AtlasAutoware/car1v2/README.md

# Atlas car 1 v2

Car 1 v2 is the rebuild of car 1, Atlas Autoware's 1/10-scale self-driving race car: a Traxxas Slash 4x4 with a
Holmes Hobbies Puller Pro 540 motor on a carbon-fibre-printed deck, carrying car 1's RPLidar C1 and OAK-D Pro. There
is one car. This repository was named `carv2` until 11 November 2026, and its older files call the car "car v2" or
"car 2". The SICK TiM561 lidar and the LUCID Triton camera that the first design was drawn around are kept for a
later upgrade. Start at `docs/CAR1V2.md`.

Rev B (October 2026) is the electronics design car 1 v2 starts from. Its electronics are:

- **Power board (ATLAS-PWR-1).** A 4-layer board that students solder at school: the motor-bus switch with
  precharge and a hardware E-stop, the power latch, the feeds for the Jetson, lidar, camera, servo and fan, USB-C
  charging, a USB hub so one laptop cable reaches the Jetson, the ESC and the serial console, and a Raspberry Pi Pico
  that sequences it all and talks to the Jetson.
- **The Jetson Orin Nano Super on its NVIDIA dev-kit carrier,** which the team owns, on a printed tray over the power
  board.
- **The team's Flipsky Mini FSESC 6.7 Pro** as the ESC (VESC firmware, the same UART commands as car 1).
- **A JBD 4S smart BMS** with the built-in 4S3P 18650 pack.

`docs/REV_B.md` has the whole design and why it changed. Rev A (two custom boards: a 6-layer drive board with the ESC
on it and an 8-layer Jetson carrier) was finished in September, quoted by PCBWay at $1,927.81 for one assembled set,
and is kept in the repo as history.

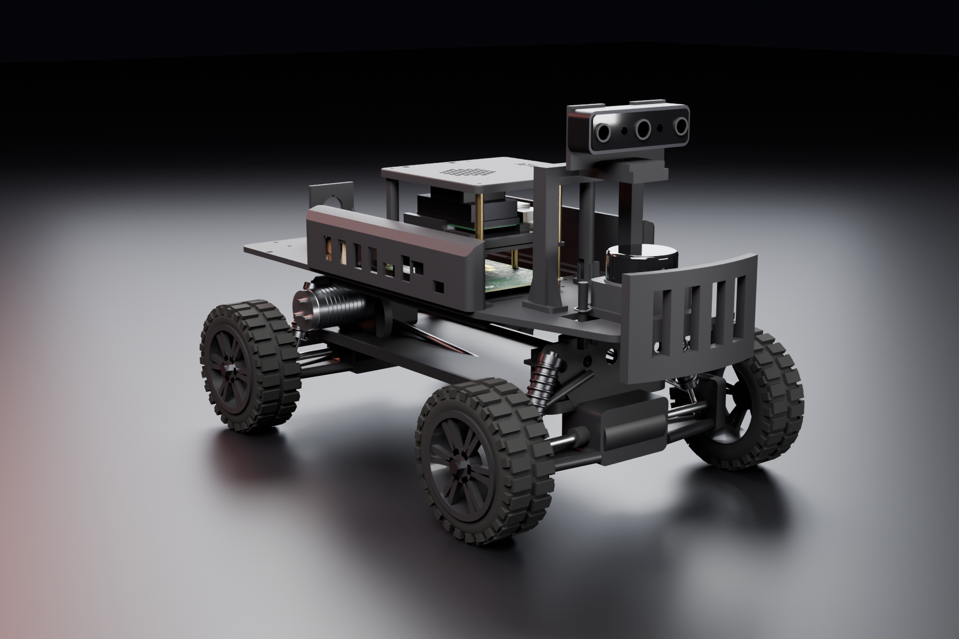
[picture p1: share/car1v2_car_front_left.png]
car 1 v2, stage 1, rendered on a stand-in Slash 4x4


The picture is car 1 v2 as designed on 9 November 2026 (`share/car1v2_scene.py`, `share/render_car.py`). Bought
parts are stand-ins, and the battery, the BMS, the fuse and the cables are not drawn. The rev A renders are
`share/car_*.png`.

## Status

**11 November 2026: the repository is renamed from `carv2` to `car1v2`.** GitHub redirects the old address. Whole-car
renders of car 1 v2 are in `share/car1v2_*.png`, and KiCad 3D renders of the power board are in
`boards/power/out/render/power_iso.png` and `power_top.png`.

**9 November 2026: car 1 v2 is designed and priced on the `rev-b-tht` branch; nothing is ordered, built or merged.**

Car 1 v2 is the rebuild of car 1 on this rev B design. It keeps car 1's RPLidar C1 and OAK-D Pro (the SICK lidar
and the LUCID camera named above are kept for later), runs from a 4S LiPo the team owns behind a JK smart BMS, and
uses the second Jetson dev kit. Start at `docs/CAR1V2.md`.

- Money: stage 1 comes to $967.72 against a $1,500 limit, and $1,272.50 if every estimate turns out badly
  (`bom/car1v2/BUDGET.md`, one cart file per supplier). Five bare boards were quoted on 9 November at $182.34
  (PCBWay) and $117.39 (JLCPCB), both before duty.
- Power board: the copper is unchanged. Three values changed after the review (R419 is 470 ohm, C405 is 150 uF, and
  the capacitor part numbers are ones in stock), and KiCad 10 was re-run on the team laptop on 9 November: ERC 0
  errors, DRC 0 errors, 0 unconnected, 0 schematic parity issues, 47 silkscreen warnings. Parts are $149.40 a board.
- An independent review (`docs/review_car1v2_2026-11-09.md`) checked the schematic, the BOM arithmetic and the budget
  and said "pass with fixes" on each. What was done about every finding is at the end of `docs/CAR1V2.md`.
- The supervisor firmware passes 129 tests on a simulated board. It has not run on a Pico.
- Speed (`docs/PERFORMANCE.md`): on 15/54 gearing the model reaches the 12.5 to 13.5 m/s target, 1.5 to 2.5 m/s
  above the 11 m/s competition benchmark. At equal grip it only matches a standard competition car round a lap, and
  the E-stop does not brake, so it is not safe to run at that speed yet. The mass (5.15 kg), the grip and the motor
  resistance in the model are not measured.
- Aero and cooling (`docs/AERO.md`): four CFD cases at 8 m/s. The wing is left off.
- For the builders: `docs/CAR1V2_QUICK_START.md` (short), `docs/CAR1V2_BUILD.md` (session by session),
  `docs/CAR1V2_CHECKLIST.md` (what to confirm, measure and test by hand), `docs/CAR1V2_WIRING.md`, and a named 3D
  assembly in `mech/out/car1v2/assembly/` (the battery, BMS, fuse and cables are not in it).
- Not verified yet: the bank balance on the day, the LiPo's size and type, the pinion and spur on the chassis, the
  duty rates, and the small-parts prices, which are estimates. `docs/CAR1V2.md` ends with the full list.

**26 October 2026: the rev B power board is routed and its order files are made; nothing is ordered or built yet.**

- An independent pre-order review (`docs/review_revb_2026-10-24.md`) said "fix first, then order; no redesign is
  needed". Its one blocker and seven majors are fixed in the design and the firmware (`boards/power/DESIGN_FIXED.md`,
  `firmware/supervisor/NOTES.md`). It asks for three bench tests before ordering; they are listed in `docs/REV_B.md`.
- The power board is designed and routed (`boards/power/`). `netcheck.py` finds 0 errors and 14 warnings (small
  back-power currents into unpowered pins, all within its limits). It is routed on four layers (2 oz outside, a 1 oz
  ground plane and a 1 oz signal layer inside; two attempts on two layers left 18-21 logic nets open round the Pico),
  and KiCad's DRC finds 0 unconnected items and 0 clearance errors (`boards/power/LAYOUT_NOTES.md`). Parts cost
  $149.37 per board at quantity 1 (`bom/revb/power_board_cost.md`); PCBWay's instant quote for five bare boards is
  $182.34 with shipping. The order files are in `boards/power/out/fab/`, renders in `boards/power/out/render/`.
- Before the boards are ordered: ERC and the KiCad 10 DRC with schematic parity on the team laptop
  (`boards/tools/run_kicad.sh erc-power` and `drc-power`; KiCad 7, used for the layout, cannot read the schematic
  sheets).
- The supervisor firmware (`firmware/supervisor/`) passes its 119 tests on a simulated board. It has not run on a
  Pico.
- The Jetson tools (`software/jetson/`) are rewritten for the dev-kit carrier and the supervisor and pass their tests,
  including the real firmware run against them over a pseudo-terminal. Nothing has run on the car.
- The printed kit (`mech/`) is redone for the dev-kit tray, the ESC cradle and the BMS holder. With a 130 mm power
  board both scripts find zero interference. The tray, the BMS holder, the canopy and the splice plates can also be
  laser-cut from 3 mm sheet, and a 3 mm acrylic shield over the live FET bar is always cut (`mech/README.md`,
  "Laser-cut parts"). The dev-kit carrier's hole positions are placeholders until the owned
  board is measured.
- Still to measure before ordering and printing: `docs/MEASURE_FIRST.md`, items 12 and 17-31. The open questions are
  at the end of `docs/REV_B.md`.

## What is in here

| folder | what |
| --- | --- |
| `docs/` | `REV_B.md` (the rev B design and why), `review_revb_2026-10-24.md` (the independent pre-order review), `BUILD_POWER_BOARD.md` (student assembly guide for the power board), `SOFTWARE.md` (what runs on the car), `FLASHING.md` (programming the Pico, the FSESC and the Jetson), `WIRING.md` (every cable run and its length), `MEASURE_FIRST.md` (numbers to check before printing and ordering), `PACK_BUILD.md` (building the 18650 pack); rev A: `ARCHITECTURE.md`, `TPS25751_CONFIG.md`, `COMPLETE_CAR.md` |
| `boards/power/` | rev B power board: `design.py` is the circuit (every value with its reason), `layout.py` the placement and power copper, `PINMAP.md` the Pico pin map, `README.md` the bench tests, `netcheck.py` the electrical checks; the KiCad schematic is generated from them |
| `firmware/supervisor/` | MicroPython for the Pico on the power board: power sequencing, E-stop latch, BMS reading, the USB link to the Jetson; a simulator and tests that run on a PC |
| `software/jetson/` | the `atlas` command, services and settings for the Jetson (`system/install.sh`), with tests |
| `software/ros2/` | `atlas_power`: battery, E-stop, charging and lidar power in ROS 2 |
| `mech/` | the printed kit: `kit.py` (deck, pods, mounts, pack box, dev-kit tray, ESC cradle, BMS holder) and `extras.py` (canopy, bench stand, plugs and cable paths); `NOTES_REVB.md` has the rev B changes and print list |
| `bom/` | rev A parts list and cost summary; `bom/revb/` the power board's parts and cost per block; `bom/car1v2/` the car 1 v2 budget and one cart per supplier; `cost_summary.md` has both revisions |
| `boards/tools/` | the scripts that build, place, route and check the boards |
| `boards/drive/`, `boards/brain/`, `boards/stack/`, `firmware/vesc/` | rev A (history): the drive board with its VESC target, the Jetson carrier forked from Antmicro's design, and the connector between them |
| `sim/` | rev A circuit and thermal checks; `sim/aero/` the car 1 v2 CFD cases and `sim/perf/` its speed and lap model |
| `share/` | pictures for posting; `car_scene.py` and `render_car.py` render the whole car (rev A; not yet updated) |

## Cost

From `bom/cost_summary.md` and `docs/REV_B.md` (prices from September and October 2026):

| | rev A | rev B |
| --- | ---: | ---: |
| Electronics for one car (rev A: one assembled PCBWay set; rev B: power board parts, BMS, BEC, fuse, leads, lidar adapter, camera cable, and the order of five bare boards) | 1,927.81 | 523.27 |
| Pack materials, lens, charger, fan, hardware, antennas | 402.55 | 376.56 |
| Castle Link (one-time, to set the servo BEC) | | 26.99 |
| **One car, new money** | **2,330.36** | **926.82** |
| **Two cars, new money** (one bare-board order for both) | **about 3,205** | **1,644.31** |

The ESC and the Jetson dev kit are owned and cost nothing new. Assembly is done by students at school. The five bare
boards are PCBWay's instant quote of October 26 ($155.79 + $26.55 DHL), before the Future Innovators discount and
customs.

## Rebuilding

Rev B:

- **Power board design files.** KiCad 7 or later and Python 3, from `boards/tools`:
  ```
  python3 make_footprints.py power
  KICAD_STOCK_SYMBOLS=/usr/share/kicad/symbols python3 build_sch.py power
  KICAD_FP_DIR=/usr/share/kicad/footprints python3 check_fp.py power
  KICAD_FP_DIR=/usr/share/kicad/footprints python3 fp_lib_from_mod.py power    # first run only
  python3 placer.py power --plot ../power/out/placement.png
  python3 ../power/netcheck.py
  python3 ../../bom/revb/make_power_bom.py
  ```
    The board is routed: do not run `placer.py` or `build_pcb.py` again unless the layout is to be redone, because they
  rebuild the board from the placement and drop the routing (`boards/power/LAYOUT_NOTES.md`, "Regenerating"). The
  order files come from `python3 fab_outputs.py power` (KiCad 7 or later). On the laptop with KiCad 10, from the repo
  root: `boards/tools/run_kicad.sh erc-power` and `boards/tools/run_kicad.sh drc-power` before ordering; not
  `pcb-power` or `fab-power`.
- **Printed kit.** `pip install cadquery ezdxf shapely matplotlib`, then from `mech/`:
  `python3 kit.py`, `python3 extras.py` and `python3 ../boards/board_outlines.py` (the default board length is the
  layout's 130 mm; `SHEET_PARTS=all` checks the laser-cut parts in place of the printed ones).
- **Supervisor firmware.** `python3 -m pytest firmware/supervisor/tests`. To put it on a Pico: MicroPython from
  micropython.org, then `mpremote connect /dev/ttyACM0 cp pins.py hal.py jbd.py link.py sequencer.py main.py :` from
  `firmware/supervisor/` (`firmware/supervisor/README.md`).
- **Jetson tools.** `sudo software/jetson/system/install.sh` on the car; tests with
  `python3 -m pytest software/jetson/tests` (needs `pytest`).

Rev A (history):

- Boards: KiCad 10 and Python 3. `boards/tools/run_kicad.sh` runs every step (schematic, board, routing export and
  import, DRC, renders, fabrication files). Careful with `pcb-drive`: it builds the board again from the placement,
  without the routing.
- VESC target: `firmware/vesc/build.sh` (clones VESC 6.06, adds the two target files, builds; needs
  `arm-none-eabi-gcc`). A build of the committed sources is in `firmware/vesc/prebuilt/`.
- Simulations: ngspice and Python with numpy, scipy and matplotlib; `sim/run_all.sh`.
- Whole-car renders: `python3 share/car_scene.py`, then `python3 share/render_car.py -- car_front_left car_exploded`
  with Blender 4.2's `bpy` module. These use the rev A model and no longer run against the rev B kit.

## Licenses

The brain board is derived from Antmicro's Jetson Orin Baseboard (Apache-2.0); its schematic and
board keep Antmicro's notices, and `boards/brain/vendor/antmicro/fetch.sh` downloads the original. The VESC
hardware target is derived from the VESC firmware (GPL-3.0), so those two files are GPL-3.0.
