AtlasAutoware/car1v2/docs/review_car1v2_2026-11-09.md

# Car 1 v2: independent review, 2026-11-09

Scope: the power board schematic as car 1 v2 will use it, the BOM math in `bom/car1v2/`, and the budget.
Read-only. This file is the only thing I wrote. Nothing was ordered, committed or pushed.

A commit landed while I was reading (ffbe478, 21:46 UTC). It changed `docs/CAR1V2.md` and
`docs/CAR1V2_CHECKLIST.md` and added `docs/CAR1V2_BUILD.md`. I read those again. Line numbers below are
for ffbe478.

## 1. Verdict

- **Schematic: pass with fixes.** The E-stop path is hardware, as described. One part value on the dev-kit
  feed (R419) is likely to keep the Jetson unpowered. One wire (Pico GP10 on the E-stop node) lets firmware
  defeat the loop. Neither needs new copper for stage 1.
- **BOM math: pass with fixes.** Every total reproduces to the cent. Two substitute capacitor lines in the
  DigiKey cart are the wrong can and must not be bought. The DigiKey tariff is about $2 low.
- **Budget: pass with fixes.** The arithmetic is right. Stage 1 stays under $1,500 in a pessimistic case
  ($1,225). Stage 1 plus phase 2 does not. Several things the build needs are in no cart.

"Blocker" below means: fix before that order or that build step. It does not mean redesign.

## 2. Findings

| id | severity | area | what is wrong | evidence | suggested fix |
| --- | --- | --- | --- | --- | --- |
| S1 | blocker | schematic, dev-kit feed | The over-voltage cut is likely to hold the Jetson's feed off at every pack voltage. A TL431 below its threshold still draws cathode current once REF is above roughly 1.3 V. That current flows in R419 (10 kOhm, base to emitter of Q404). About 60 uA turns Q404 on, and Q404 pulls the gate of Q402 to its source. Predicted from datasheets, not measured | nets OV_K, OV_B, OV_G: U402, R419, R420, Q404, Q402 (`design.py`:310-318). `netcheck.py`:466-468 and 508-509 treat an off TL431 as open. TI datasheet: Ioff is given only at Vref = 0; Imin 0.4 mA typical. Wikipedia "TL431": 100 to 200 uA below threshold | Fit 470 Ohm at R419 (same 1206 pads; the cart has ten 470 Ohm and uses five). Keep the 16.8 V step in `CAR1V2_BUILD.md` test 2. Try U402, Q404 and the resistors on a breadboard first |
| S2 | should fix | schematic, E-stop | Pico GP10 is wired straight to the ESTOP_OK node. A pin driven high would hold the node at 3.3 V against R1003 with the loop open. The shipped firmware only reads the pin, so "no firmware in the path" holds by firmware convention, not by hardware | net ESTOP_OK: MOD701 pin 14, U302 pins 2 and 5, R1002, R1003, C1001 (`design.py`:460, 583-585; `atlas_power_g_super.kicad_sch`:874). `hal.py`:52-53, `pins.py`:65. `CAR1V2.md`:76-77 | Rev C: 47 kOhm between the node and GP10. On these boards: cut the track at pin 14 and bridge it with 47 kOhm, or accept it and add a test that ESTOP_OK is never an output. Reword `CAR1V2.md`:76-77 |
| S3 | should fix | settings | The Jetson's battery daemon powers the Jetson off at 3.50 V a cell held for 30 s. That is the same 14.0 V and 30 s as the supervisor's warning. With no BMS current the daemon uses the raw pack voltage. So the car shuts down at the "warn" level and the 13.2 V step is only a backstop. The table in `CAR1V2.md` says otherwise | `setup_car1v2.sh`:49-50; `battery.py`:102-103, 219-226; `car_profile.py`:20-21; `CAR1V2.md`:69-70 against 128; `CAR1V2_BUILD.md`:26, 213 | Decide which is wanted. Set `ATLAS_SHUTDOWN_CELL_V` to about 3.35, or rewrite the table as "14.0 V for 30 s: the Jetson shuts down" |
| S4 | should fix | checklist | Step E3 says pull the Pico with the car on. That also cuts the Jetson's DC feed with no shutdown. Q403's base drive comes from the Pico's 3.3 V through R415 | nets +3V3, DEVKIT_PWR, DEV_B: R415, R413, Q403, Q402. `CAR1V2_CHECKLIST.md`:80; `CAR1V2_BUILD.md`:178-179, 212 | Do that test with the Jetson halted or its DC lead unplugged. Say so in E3 |
| S5 | should fix | settings | No regen current limit for the VESC and no charge over-current for the JK BMS are listed. Braking current is charge current to the BMS. If it exceeds the BMS limit the BMS opens during braking and the bus jumps. Rev B listed -12 A and about 20 A | `CAR1V2.md`:116-128; `docs/SOFTWARE.md`:123; `docs/FLASHING.md`:21-22 | Add "battery current max regen -12 A" and "JK charge over-current 20 A or more" to the table and the sign-off |
| S6 | should fix | settings | The supervisor's cut (3.30 V a cell) and the BMS cut (3.20 V) are 0.4 V apart at the pack. The Pico's reading can be off by about that much (1 % resistors, the 3.3 V reference, ADC offset). If it reads high, the BMS cuts first and the Jetson loses power without a shutdown | R703, R704; `pins.py`:85-87; `car_profile.py`:21; `CAR1V2.md`:70-71 | Compare `bat` in the status with a meter at bring-up and store a scale factor. Or set the BMS to 3.00 V, as rev B did |
| S7 | note | schematic, E-stop | Car 1 v2 loses rev B's last fallback: the Pico cannot tell the BMS to open. A main FET that fails shorted leaves only the firmware VESC kill line and the XT90-S. Also, a short between the two loop wires, or loop pin 2 to any voltage above 2 V, reads as "run" | `REV_B.md`:472-473; `sequencer.py`:903-906; J1001 | Say it in `CAR1V2.md`. Test the VESC kill line by itself in E3 |
| S8 | note | docs | "Each branch on the board has its own fuse or polyfuse" is not true. The UBEC feed (J401 on VM), the latch feed (BAT to MOD401 on 18 AWG) and SERVO_V have none. The 5 V branch has only R408 | `CAR1V2.md`:64; nets VM, BAT, SERVO_V, V5_IN | Correct the sentence. Consider an inline blade fuse in the latch lead and in the UBEC lead |
| S9 | note | stage 1 population | With MOD502 off, CHG_GND floats, and Q502 and Q503 float with it. Nothing misreads: CHG_PRESENT_N rests high through R507. F501 with its fuse keeps CHG_RB at pack voltage. The camera pads are live through F403 | nets CHG_GND, CHG_RB, CAM_VIN; `power_board_stage1.csv` rows "F401 F501" and "F402 F403" | Leave the 5 A fuse out of F501 in stage 1. Keep the Kapton over the empty pads |
| S10 | note | DRC text | Three of the 14 silk_over_copper warnings are hub labels over through-hole pads of U601, not over power copper. "None is on a pad" is wrong. No electrical effect | `drc.rpt`:177, 181, 185; `LAYOUT_NOTES.md`:370; `CAR1V2.md`:95-96 | Correct both sentences |
| S11 | note | LiPo | The limits assume 4.20 V cells. A LiHV pack (17.4 V) is over D101's 17.1 V standoff and inside the cut-off's release band. Nobody has recorded the pack type | D101; U402 divider; checklist A1 | Add "LiPo or LiHV" to A1 |
| B1 | blocker | BOM, DigiKey cart | Two substitute capacitors are not "long-lead versions". DigiKey lists EEU-FR1V681L as 10 mm wide and 27 mm seated (a 25 mm can), and EEU-FR1C102L as 8 mm wide with 3.5 mm lead spacing. C101 to C103 sit under the dev-kit tray, limit 23 mm. C404's footprint has 5.0 mm spacing | `make_car1v2.py`:98, 104; `power_board_bom.csv` rows C101 and C404; `mech/kit.py`:54; `CAR1V2.md`:108-110; `CAR1V2_CHECKLIST.md`:66-67; `CAR1V2_BUILD.md`:53-54 | Take both L lines out. Buy a 10 by 20 mm, 5.0 mm pitch 680 uF 35 V part and a 10 by 16 mm, 5.0 mm pitch 1000 uF 16 V part. Read the size on the product page before adding |
| B2 | should fix | BOM, DigiKey cart | The by-hand line for C405 names Nichicon UPW1V221MPD. DigiKey lists it as a 10 mm can with 5.0 mm spacing. The footprint is 8 mm and 3.5 mm. The line also suggests an "L" packaging. No real part was chosen for C405 or for the 10 uF parts | `make_car1v2.py`:118-121; `power_board_bom.csv` row C405 | Pick part numbers and check each against its footprint |
| B3 | should fix | BOM math | The DigiKey tariff is scaled by merchandise ($26.76). The kept lines alone add to $26.86 in the cart's own per-line column. Three kept lines had no figure and the six by-hand lines carry none. About $2 low | `make_car1v2.py`:235; `cart_digikey.csv` tariff column | Sum the per-line figures and estimate the rest |
| B4 | should fix | BOM labels | Two by-hand lines are filed as read today and were not: the 220 uF line as "cart" (it is another part's price) and the tactile switch as "page" (Mouser through findchips, zero stock). `BUDGET.md` opens with "prices read 2026-11-09", but $610.61 of $854.86 is quote or estimate. The basis table says "merchandise only" and includes $168.16 of duty and shipping | `make_car1v2.py`:120-121, 125-126, 312, 346; `BUDGET.md`:3, 37-44 | Relabel both lines "est". Reword the two sentences |
| B5 | should fix | BOM coverage | Needed and in no cart or shelf line: soldering tips, storage for the second Jetson if it has none, a LiPo bag, the 3-pin servo-signal lead from the FSESC to J904, a motor sensor adapter if the plugs differ, thin hookup wire for the latch and the E-stop loop, M3 nuts, M2.5 and M4 screws. The Wi-Fi adapter and joystick receiver are needed in session 7, before the swap | `CAR1V2_WIRING.md`; `cart_other.csv`; `shelf.csv`; checklist A2, A8; `CAR1V2_BUILD.md`:181-190 | Add lines with estimates. About $110 with tax in my pessimistic case |
| B6 | note | BOM coverage | The cart builds one board, not five. Eight parts are bought once: U401, MOD401, MOD601, J409, J601, U601, J801, J1003 | `cart_digikey.csv` | Fine if intended. Say so |
| B7 | note | BOM math | The DigiKey row in `BUDGET.md` adds to 203.94 from its own cells; the total shows 203.95. Rounding only. Two doc figures do not match the BOM: "about $4" for the parts left for later is $7.86, and "About $11" for the hub block is $15.84 at cart prices | `BUDGET.md`:28; `CAR1V2.md`:85, 101; `power_board_stage1.csv` | Cosmetic |
| M1 | should fix | budget, docs | `CAR1V2.md` and `BUDGET.md` disagree twice. "Five in-stock substitutes went into the cart": three are in the cart, two are unspecified by-hand lines. "Six DigiKey lines not read today": `BUDGET.md` files two of them as read today | `CAR1V2.md`:108-110, 162-164; `BUDGET.md`:41-42, 46 | Align the text |
| M2 | note | budget | Stage 1 plus phase 2 has $80.54 of room. A duty of 61 % alone removes it. So does 55 % duty with small parts 15 % over. Stage 1 alone holds | my recomputation; `BUDGET.md`:54 | Treat phase 2 as not yet affordable inside the cap |
| M3 | note | budget | The pending bank items (Micro Center $199.11, FS.COM $83.08, Adafruit $31.49) are not explained. If any is car 1 v2 spending it counts toward the $1,500 | `make_car1v2.py`:21-22 | State what they were for |
| M4 | note | docs | `CAR1V2.md` says "the reviewer checked that path" before any review existed | `CAR1V2.md`:77 | Replace with this review's result (S2, S7) |
| F1 | note | firmware tests | `test_healthy_lipo_is_left_alone` asserts on an event name that does not exist ("bat_low"; the event is "low_battery"), so it cannot fail. No test sits at the 14.0 V and 13.2 V edges. I ran the edges by hand and they behave as documented | `test_car_profile.py`:53; `sequencer.py`:453, 463 | Fix the name. Add cases at 13.95, 14.05, 13.15 and 13.25 V |

## 3. Detailed answers

### How I checked the schematic

I read `design.py` and `chips_power.py`, then checked them against three other things. First, the netlist in
`atlas_power_parts.json` (215 parts, 133 nets). Second, the net labels in the `.kicad_sch` sheets for the
nets that matter here. Third, the pad nets in `atlas_power.kicad_pcb`: all 574 pads match the netlist. The
sheets are KiCad 9 format files (`version 20250114`), not KiCad 7. The board file is KiCad 7 format.

### 1a. E-stop

The path, in order:

1. `+3V3` (the Pico's 3.3 V output) through R1001 (1 kOhm) to J1001 pin 1, net ESTOP_SRC.
2. The normally closed button and its two wires.
3. J1001 pin 2, net ESTOP_IN, with BAT85 clamps D1001 to GND and D1002 to +3V3.
4. R1002 (100 Ohm) to the node ESTOP_OK, which has R1003 (10 kOhm) and C1001 (10 nF) to GND.
5. ESTOP_OK to U302 (74HCT08) pins 2 and 5. Pin 1 is MAIN_EN, pin 4 is PRECHARGE_EN.
6. U302 pin 3, AND_MAIN, through R305 (1 kOhm) to MIC_IN, with R306 (100 kOhm) to GND.
7. U301 (MIC5014) pin 2 in, pin 5 out to SW_GATE, then R301 to R303 (10 Ohm) to the three gates. R304
   (2.2 MOhm) ties gate to source.
8. For precharge: U302 pin 6, AND_PRE, through R311 to Q305, which pulls the gate of Q304.

There is no firmware-controlled part in series. The cases asked about:

- **Loop wire broken or button unplugged.** ESTOP_IN floats. R1003 holds ESTOP_OK at 0 V. Both AND outputs
  go low. R306 holds MIC_IN low. The switch opens and precharge is off. The node falls below the gate's 0.8 V
  low level in about 0.13 ms.
- **Pico unpowered or pulled out.** `+3V3` has no other source, so the loop has no supply and ESTOP_OK is 0 V.
  R307 and R308 (100 kOhm) hold MAIN_EN and PRECHARGE_EN low. The switch opens. The Jetson's feed also drops
  (finding S4).
- **Pico in reset, pins floating.** R307 and R308 hold both enables low. The switch opens. ESTOP_OK does not
  depend on the Pico's pin state in reset.
- **74HCT08 out of its socket or without 5 V.** R306 holds MIC_IN low. Switch open.
- **MIC5014 out of its socket.** R304 holds the gates at the source. Switch open.

What is not as strong as the docs say:

- GP10 sits directly on ESTOP_OK (finding S2). The shipped firmware makes it an input with no pull
  (`pins.py`:65, `hal.py`:52-53) and hangs an interrupt on it (`hal.py`:112). No code path makes it an output.
  But a wrong pin table, a bug, or someone at the REPL can drive it high, and 10 kOhm cannot hold it down. An
  internal pull-up alone cannot defeat the loop: I estimate under 0.6 V at the node. I took the RP2040's
  pull-up value (50 to 80 kOhm) from memory. Not verified.
- The loop is one channel. A short between its two wires reads as "closed". So does pin 2 touching anything
  above 2 V.
- A main FET that fails shorted defeats the hardware layer. Rev B answered that with "the Pico can tell the
  BMS to open" (`REV_B.md`:472-473). On car 1 v2 the BMS is not on the UART, so that answer is gone (S7).
- The E-stop cuts the motor bus only. The UBEC is on that bus, so steering drops too and the car coasts.
  The Jetson stays on. This is by design, and worth saying to the students.

### 1b. Stage 1 population

With MOD402, MOD501 and MOD502 not fitted, and R801, R802 and R805 never fitted:

| input or node | state in stage 1 | does it matter | firmware |
| --- | --- | --- | --- |
| CHG_PRESENT_N (GP15) | high through R507 (10 kOhm). Q503's emitter is on CHG_GND, which floats, so it cannot pull the line low. Leakage through Q502 and Q503 is nanoamps against 10 kOhm | no | reads "no charger". The low-pack checks are never paused (`sequencer.py`:276, 445). Correct |
| CHG_GND island (Q502, Q503 emitters, R504, R506, D501, C501, TP502) | floats. Its only tie to GND was inside MOD502 | no. Q501's gate is held off by R501 to CHG_RB, not by the island | none needed |
| CHG_RB, Q501 source | at pack voltage through F501 if its fuse is fitted | harmless, but a live unused branch (S9) | none |
| CHG_OUT, CHG_IN pads | float | no | none |
| CAM_VIN pads | at pack voltage through F403 whenever the latch is on. D406 across them | bare live pads. Kapton, as the build guide says | none. There is no camera enable or power-good net on this board |
| BMS_RX (GP1) | idle high through R202 with J201 empty | no | BMS reported offline; `bms_fets` returns an error; pack voltage comes from the ADC. Tested (`test_car_profile.py`:21-27) |
| I2C0_SDA, I2C0_SCL (GP4, GP5) | float. R801 and R802 are not fitted | no. The pins are never read | set as inputs with no pull (`pins.py`:75). A pull-down would be tidier |
| J12_CTS | floats at the Jetson (R805 not fitted) | same as rev B | none |
| LIDAR_V at J409 | off at boot (`LIDAR_AT_BOOT = False`). Goes live if the Jetson raises LIDAR_REQ | nothing is plugged in | handled |
| VM_SENSE, BAT_SENSE, FET_NTC | unchanged. None depends on a missing module | no | unchanged |

There is no "charge enable" output in this design. The charge path is gated in hardware by D502 and Q502.

The pack still powers the board. The pack comes in on J101 and J102 straight to BAT. The charge path is a
separate branch into BAT and is not in the way.

Two inputs change behaviour against rev B: the BMS never answers, and the lidar feed stays off. The firmware
handles both.

### 1c. LiPo instead of the 18650 pack

A 4S LiPo and the 4S 18650 pack have the same full voltage, 16.8 V. So no rating gets tighter. What changes
is that the pack type is unknown (S11).

| part | limit | at 12.0 to 16.8 V | at a spike | source |
| --- | --- | --- | --- | --- |
| D101 1.5KE20A (BAT) | standoff 17.1 V, breakdown 19.0 to 21.0 V, clamp 27.7 V | 0.3 V under the standoff at a full pack | clamps | values from `design.py`:142. Not read on a datasheet today |
| D301 1.5KE22A (VM) | standoff 18.8 V | fine | clamps at about 30.6 V | standoff from `design.py`:218; the clamp figure is from memory. Not read today |
| C101 to C103 | 35 V | fine | fine | DigiKey page |
| C104, C301, C302 | 50 V | fine | fine | part numbers |
| U301 MIC5014 | 2.75 to 30 V operating, 60 V absolute, gate clamp 13 to 17 V, shuts off at 35 V minimum | fine | under 30 V at the clamp | MIC5014/5015 datasheet copy at docs.rs-online.com, read today |
| Q301 to Q303 IRFB7430 | 40 V | fine | fine | `chips_power.py`. Not read today |
| Q304, Q405 IRF9Z34N | 55 V, gate 20 V | gate at -8.4 V at 16.8 V | -13.9 V at 27.7 V | arithmetic from R309, R310 |
| U401 R-78E5.0-1.0 | 8 to 28 V in, behind R408 and D401 (P6KE20A) | fine down to the 13.2 V cut | clamped near 20 V | `design.py`:237. Not read today |
| MOD401 Pololu 2813 | 4.5 to 40 V per the repo | fine if that is right | fine if that is right | not verified: the Pololu page was blocked |
| Q402 IRF4905 | 55 V, gate 20 V | gate at -7.1 V at 12 V, -10 V at 16.8 V | -18.2 V at 30.6 V | arithmetic from R411, R412 |
| U402 over-voltage cut | see below | does not trip | trips | arithmetic |
| C404 on SERVO_V | 16 V | 7.4 V from the UBEC | not on the pack rail | BOM |
| C405 on VDEV | 35 V | fine | fine | BOM |
| VM_SENSE, BAT_SENSE | 100 kOhm over 18 kOhm, factor 0.1525 | 2.56 V at 16.8 V | see below | arithmetic |

**The over-voltage cut.** With R416 100 kOhm, R417 15.0 kOhm, R418 1.2 MOhm and the gate at 0.405 of the feed:

- Trip: 18.7 V with no reference current, 18.9 V with the typical 2 uA. With 1 % resistors, the A-grade
  reference (2.470 to 2.520 V) and 0 to 4 uA, the range is about 18.2 to 19.6 V. Allowing for drift, about 18.0 V
  at the lowest. The docs say 18.7 V.
- Release: 17.85 V nominal, 17.4 V at the low corner, about 17.2 V with drift. The docs say 17.85 V.
- A full pack at 16.8 V is at least 1.2 V under the lowest trip and at least 0.4 V under the lowest release.
  The highest trip, 19.6 V, is under the carrier's 20 V. So the thresholds are right.
- The problem is not the threshold. It is the off-state current (S1). The TI datasheet gives the off-state
  cathode current only for Vref = 0, and lists 2 uA typical into REF and 0.4 mA typical minimum cathode
  current. The REF pin here sits at 1.6 V (12 V pack) to 2.24 V (16.8 V pack). In that state the Wikipedia
  article on the TL431 puts the cathode current at 100 to 200 uA, climbing to 300 to 500 uA close to the
  threshold. A TI application note (SNVAA58) describes the same state as a few microamps, so the sources
  disagree. At 100 uA, R419 would drop 1 V, which is more than Q404 needs to turn on. Q404 then holds Q402
  off, and R418 feeds REF a little more, so it stays that way. `netcheck.py` cannot see this because it
  models the off state as an open circuit. With 470 Ohm at R419, Q404 needs about 1.2 mA to turn on, which
  is above the 0.6 mA maximum the datasheet gives for the A grade, and it still gets 2 mA of base current
  at the trip point. The build guide's test 2 would catch this on the bench. The fix costs nothing.

**The ADC dividers.** At 16.8 V the pins see 2.56 V. They reach 3.3 V at 21.6 V on the bus. At the pack TVS
clamp (27.7 V) the divider would give 4.2 V open-circuit, so the Pico's pad diode conducts: about 30 uA. At
the motor-bus clamp (30.6 V), about 60 uA. So they do not stay under 3.3 V at the clamp. They rely on the
pad diode at a very small current for the length of the spike. I did not read the RP2040's limits. Not
verified.

**Regen.** The repo's answer is the VESC's 18 V input limit, with the TVS parts as backstop. That is unchanged.
The missing piece for this car is the pair of regen settings in S5.

### 1d. Supervisor with no BMS traffic

- `python3 -m pytest firmware/supervisor/tests -q`: 126 passed. The Jetson tools: 77 passed. Both match
  `CAR1V2.md`:142-143.
- Boot and main switch with a silent BMS: yes. `main.App` always builds a `JbdClient`; it times out and
  reports offline; `_bms_watch` does nothing more (`sequencer.py`:468-479). The rig reaches RUN with MAIN_EN
  and VESC_KILL high and the lidar feed off.
- Low pack from its own ADC: yes. `_battery` (`sequencer.py`:431-466) uses the filtered BAT_SENSE reading only.
- Thresholds: `car_profile.py`:20-21 has 14.0 V and 13.2 V. `BAT_LOW_MS` 30 s and `BAT_CUT_MS` 10 s are
  inherited. These match `CAR1V2.md`:69-70 and the VESC cut-off line.
- I ran the rig at the edges, outside the repo. 14.05 V: no event in 60 s. 13.95 V: warning at 30.1 s. 13.25 V:
  warning only. 13.15 V: shutdown requested at 10.1 s. A sag from 15.2 V to 12.9 V needs about 14 s before it
  cuts, because of the 2 s filter. A pack that reads under 10 V at power-on ends in FAULT.
- Sensible for a 4S LiPo? Yes as starting values. 3.50 V a cell at cruise current is roughly the last fifth
  of the pack. 3.30 V held for 10 s leaves room above 3.0 V. Two caveats: S3 (the Jetson acts at 14.0 V on its
  own, so the 13.2 V step is rarely reached) and S6 (measurement error against the BMS's 3.20 V).
- Test quality: F1.
- One thing outside the supervisor: the Jetson's estimator uses 8.4 Ah (`board.py`:51) and counts charge
  from BMS current. With no current, its state of charge stays at the start value. "Battery telemetry, pack
  level" means voltage only.

### 1e. The servo

- The UBEC's input is J401 (BEC+, net VM) and J402 (GND). Its output plugs into J403: pin 1 not connected,
  pin 2 SERVO_V, pin 3 GND. J404 and J405 are solder pads on the same nets.
- The servo plugs into J406: pin 1 SERVO_SIG, pin 2 SERVO_V, pin 3 GND.
- The FSESC's signal comes in on J904 pin 1 through R903 (10 kOhm) to U302 pin 9. The buffer output goes
  through R410 (220 Ohm) to J406 pin 1. J904 pin 2 is not connected, so the FSESC's own 5 V cannot meet the
  UBEC's 7.4 V. J904's ground goes through R906 (3.3 Ohm).
- Parts on SERVO_V: J403, J404, J406, C404 (1000 uF 16 V) and TP403. Nothing rated 5 V is on it. The only
  5 V part near it is the buffer, and it drives the signal pin through 220 Ohm. 7.4 V is safe. 8.4 V would be
  too.
- Copper: the class is 2.5 mm on 2 oz. The built track is 2.0 mm for 61 mm, 1.9 mm for 27 mm and 1.6 mm for
  9 mm (`LAYOUT_NOTES.md`:300). That carries several amps.
- There is no fuse or polyfuse on SERVO_V, and none on the UBEC's input lead (S8). The 2.54 mm header pins
  are rated about 3 A (from memory, not read today) and a stalled 35 kg cm servo can draw more for a moment. If the UBEC has bare output
  wires, solder them to J404 and J405 instead of using J403. I did not find the INJS235's stall current. Not
  verified.
- The substitute bought for C404 has the wrong lead spacing (B1).
- The UBEC loads the motor bus during precharge. Checklist C2 and build test 4 cover that.

### 1f. The ERC and DRC reports

- `erc.rpt`: 0 errors, 0 warnings. As claimed. The ignored checks are library and footprint-link checks, not
  pin or power checks.
- `drc.rpt`: 47 violations, all warnings: 33 silk_overlap and 14 silk_over_copper. 0 unconnected pads.
  0 footprint errors. As claimed.
- On a pad or an electrical feature? The 33 are silkscreen against silkscreen. Of the 14, eleven are against
  the mask openings over the BAT and VM copper. Three are hub labels over through-hole pads of U601 (pads 1,
  13 and 2). So "all on the bare power copper" and "None is on a pad" are not exact (S10). The fab clips ink
  at mask openings, so there is no electrical effect.
- The board file carries `dnp` on R801, R802 and R805 and on nothing else. Commit 0071d04 changed those three
  attribute lines only. The Gerbers in `out/fab` date from 9963a99 (Oct 26) and are unaffected.
- The reports are stamped 15:48 local time. If the laptop is on US Eastern time, that is seconds after the
  commit (20:47 UTC), so they describe the board with the flag. I could not rerun them: KiCad is not
  installed here.

### 1g. Other defects, ranked

1. S1, the TL431 off-state current. Likely to stop the Jetson powering at all.
2. S2, GP10 on the E-stop node.
3. S3, the Jetson shutting down at the warning level.
4. S4, the Pico-pull test cutting the Jetson.
5. S5 and S6, the missing regen settings and the uncalibrated cut level.
6. S7 to S11, notes.

Two more small ones. There is no reverse-polarity protection at the BAT pads, and D101 conducts forward if the
pigtail is soldered backwards, so meter the pigtail before the first plug-in. And the BOM names TL431ACLPRE3,
a formed-lead part, for a straight-lead TO-92 footprint; the by-hand line allows TL431ACLP, which is the
straight one.

### 2a. Recomputed totals

I recomputed from the CSV files with my own script, in exact decimals.

| figure | files say | I get |
| --- | --- | --- |
| DigiKey cart, all 79 lines | 164.72 | 164.72 |
| DigiKey kept lines (73) | (not shown) | 150.69 |
| DigiKey by-hand lines (6) | (not shown) | 9.96 |
| DigiKey merchandise | 160.65 | 160.65 |
| DigiKey tariff, scaled | 26.76 | 26.76 by the script's method; 26.86 from the kept lines' own column, before the unread and by-hand lines (B3) |
| DigiKey tax | 11.54 | 11.54 |
| DigiKey total | 203.95 | 203.95 (the row's cells add to 203.94) |
| PCBWay, one order | 236.87 | 236.87 (duty 54.53 is 35 % of 155.79) |
| Amazon BMS with tax | 70.48 | 70.48 |
| Hobbywing with tax | 32.85 | 32.85 |
| Small parts with tax | 130.37 | 130.37 |
| **Stage 1** | **911.39** | **911.39** |
| Phase 2 with tax | 508.07 | 508.07 |
| Phase 2, borrowed welder | 185.29 | 185.29 |
| Sensor upgrade with tax | 84.64 | 84.64 |
| Stage 1 + phase 2 | 1,419.46 | 1,419.46 |
| Stage 1 + phase 2 (borrowed welder) + upgrade | 1,181.32 | 1,181.32 |
| Stage 1 + phase 2 + upgrade | 1,504.10 | 1,504.10 |
| Basis: cart, page, quote, est | 152.11, 92.14, 371.56, 239.05 | the same |
| Board population: fitted, left off | 105.47, 43.90 | the same; they add to the rev B BOM's 149.37 |

Every line is quantity times unit price to the cent. The only differences of a cent or more are the row
rounding (B7) and the tariff method (B3).

### 2b. Coverage

Every row marked "fit" has a line that buys it, for one board. The three that are not DigiKey part lines:
the heatsink bar (SendCutSend gift code), the Pico's headers (the cart buys the Pico H, which has them), and
the hub module's headers, the M3 nuts and the Kapton (not bought as such; Kapton is in a small-parts line).

The cart builds one complete board (B6). No part is bought that the board does not use, apart from spares and
the dev-kit DC lead, which is a harness part. Six lines sit in the cart that must come out or be decided
before checkout: five to delete ($8.08) and the PD trigger ($5.95).

Substitutes against the footprint in the BOM row:

| refs | BOM footprint | substitute | check |
| --- | --- | --- | --- |
| C101 to C103 | CP_Radial_D12.5mm_P5.00mm | EEU-FR1V681L | 680 uF 35 V. 10 mm can, 5.0 mm spacing: fits the holes. 27 mm seated maximum: 4 mm over the tray limit. **Wrong** |
| C404 | CP_Radial_D10.0mm_P5.00mm | EEU-FR1C102L | 1000 uF 16 V. 8 mm can, 3.5 mm spacing against 5.0 mm holes, 22 mm seated maximum. **Wrong** |
| C104, C603, C604 | C_1206 | KEMET C1206C105K5RACTU | 1 uF, 50 V, X7R, 1206 by its part-number code. Fits. Not read on a page |
| five 10 uF | C_1210 | "any", for example KEMET C1210C106K5RACTU | the example decodes as 10 uF, 50 V, X7R, 1210. No part chosen |
| C405 | CP_Radial_D8.0mm_P3.50mm | "any"; names UPW1V221MPD | the named part is 10 mm and 5.0 mm. **Wrong example.** No part chosen |

Pages read: DigiKey product pages for EEU-FR1V681L, EEU-FR1C102L, EEU-FR1V681, EEU-FR1C102, EEU-FR1V221 and
UPW1V221MPD (regional DigiKey sites; I used the size attributes only, not price or stock).

A side finding: DigiKey lists the original EEU-FR1V681 as a 10 mm can, 22 mm seated. The rev B BOM calls it
12.5 by 20 mm. The footprint is drawn larger than the part. Harmless.

### 2c. Tax, shipping, and every item in the wiring diagram

Tax is on DigiKey (merchandise, tariff and shipping), Amazon, Hobbywing (with shipping) and small parts. It
is not on PCBWay, which carries duty instead. That is right, and slightly generous where shipping is taxed.
Nothing is counted twice: the PD trigger is in the DigiKey file as "phase2" and is costed only in phase 2.
The second board order is in stage 1 as a reserve, $236.87.

Not counted: the tariff on the by-hand lines, a carrier's duty-handling fee if PCBWay does not collect duty at
checkout, shipping on small parts from sellers that charge it, and a split shipment for the three backordered
DigiKey lines.

| item in the wiring diagram | where it comes from |
| --- | --- |
| 4S LiPo | `shelf.csv` (car 1's packs; size, rating and type unrecorded) |
| MIDI fuse 100 A and holder | small parts, estimate $12.00 |
| JK BMS | Amazon, $66.49 |
| XT90-S | small parts, estimate $6.00 |
| 10 AWG leads, ring terminals, heat-shrink | small parts, estimates $10.00 and $7.00 |
| XT90 to mate with the pack, XT90 male for the board pigtail | `shelf.csv` (three XT90s, two bare-wire cables; gender and gauge unconfirmed, checklist A6) |
| balance-lead extension | small parts, estimate $6.00 |
| bare board | PCBWay |
| board parts, Pico, hub, latch | DigiKey cart |
| latch wiring: 18 AWG | small parts (16 and 18 AWG wire, $8.00) |
| latch ON and OFF wires, thin | **not listed** |
| E-stop button | small parts, estimate $9.99 |
| E-stop lead to J1001 | the pre-crimped JST lead line, estimate $9.00. Length to the tail not checked |
| FSESC | `shelf.csv` (the spare) |
| ESC power leads, motor phase leads and bullets | assumed to be on the FSESC and motor. Not verified |
| motor sensor lead | "in the box", checklist A4. Adapter to the FSESC's socket **not listed** |
| UBEC | Hobbywing Direct, $24.99 plus $6.00 estimated shipping. Output plug type unknown (checklist B8) |
| servo | `shelf.csv` |
| FSESC servo-signal lead to J904 | **not named** in any line |
| FSESC COMM lead to J903, J14 harness | the pre-crimped lead and Dupont line |
| dev-kit DC lead | DigiKey, $4.51 |
| second Jetson | `shelf.csv`. Storage unconfirmed |
| 40-wire ribbon | small parts, estimate $4.00 |
| Pico USB lead, three hub leads | the USB leads line, estimate $22.00 |
| RPLidar C1, OAK-D Pro and their leads | car 1, moved on swap day |
| Wi-Fi adapter, joystick receiver | car 1, moved on swap day. **Not in `shelf.csv`**, and needed in session 7 before the swap |
| laptop USB-C cable | not listed; assumed owned |
| fan | `shelf.csv` (model unconfirmed) |
| heatsink bar, acrylic shield | SendCutSend gift code |
| standoffs, inserts, Kapton, ties, plywood | small parts, estimates |

### 2d. Price labels

- Labelled as read today and not: the 220 uF by-hand line ("cart", but it is the price of a different,
  backordered part) and the tactile switch ("page", but read at Mouser through an aggregator, for a part to
  be bought at DigiKey).
- Labelled as an estimate though a price was read: the TL431 ($0.50 against $0.14 read on Oct 24). This errs
  high.
- `BUDGET.md` line 3 says the prices were read on 2026-11-09. By its own table, $244.25 was read that day and
  $610.61 was not.
- The Hobbywing price I could check: the Hobbywing Direct page shows $24.99. The page does not say how the
  output voltage is selected, so "its voltage is a jumper" is not verified.

### 3a. Bank arithmetic

1,895.60 + 250.00 - 199.11 - 83.08 - 31.49 = 1,831.92. Correct.
After stage 1: 1,831.92 - 911.39 = 920.53. Correct. Under the cap: 1,500.00 - 911.39 = 588.61. Correct.
After stage 1 and phase 2: 1,831.92 - 1,419.46 = 412.46. Under the cap: 80.54. Correct.
With the sensor upgrade as well: 327.82 left in the account, 4.10 over the cap. Correct.

### 3b. `CAR1V2.md` against `BUDGET.md`

These agree: 1,831.92; 1,500; 911.39; 66.49; 24.99; 73.94 for the Castle parts; 508.07; 185.29; 1,419.46;
84.64; "$323" for the welder with tax (322.78); 35 % duty; 6 % tax; five boards.

These do not: the two items in M1; the low-voltage table against the Jetson setting (S3); "about $4" and
"About $11" (B7).

### 3c. What moves the total

| assumption | change | stage 1 moves by |
| --- | --- | --- |
| the reserve second board order is not needed | drop it | -236.87 |
| PCB quote | +10 % | +42.06 (two orders, with duty) |
| duty rate | +10 points | +31.16 (two orders) |
| small-parts estimates | +10 % | +13.04 |
| sales tax | +1 point | +4.13 |
| DigiKey tariff counted by line | about +2 | +1.84 |

The largest single item is whether the second board order happens. After that, the PCB quote and the duty.

A pessimistic but plausible stage 1: PCB quote 15 % higher, duty 55 %, DHL 10 % higher, small parts 30 % over
plus $15 shipping, DigiKey by FedEx with the tariff by line, Hobbywing shipping $10, and $103 of the missing
items in B5 (tips $28, storage $45, LiPo bag $12, leads $10, wire $8). That comes to **$1,225.45**, with the
reserve order included. It clears $1,500 by $274.55. With one board order it is $918.54. Adding phase 2 to the
pessimistic case gives $1,733.52, which does not clear.

### 3d. Missing from the money

Listed in B5. The ones that could stop the car driving: storage for the second Jetson (if checklist A2 finds
none), soldering tips (if A8 finds none), the servo-signal lead, and a sensor adapter if the motor's plug and
the FSESC's socket differ. The bench tests in the checklist also assume a current-limited supply, a scope, a
4.7 Ohm 50 W resistor and a load for 50 A pulses (A11). None is priced.

## 4. What I could not verify

- **S1 is a prediction.** No hardware exists. Two sources support it and one TI note disagrees. A breadboard
  settles it in minutes.
- KiCad's ERC and DRC. I read the two report files. I could not rerun them.
- Whether the Gerbers in `out/fab` match the board file. I checked only that the one later commit touched
  attribute lines.
- Datasheet values taken from the repo and not read today: the TVS parts, the IRF FETs, the R-78E, the
  74HCT08, the PC817, the Pico's pin limits and pull values.
- Blocked or failed pages: pololu.com/product/2813 (the latch's limits and its ON pin), chenshuo.com/notes/tl431
  (a TL431 circuit analysis), and one allaboutcircuits.com thread. The TI datasheet was read only through its
  first 100,000 characters, which covered the tables and the comparator section; the cathode-current figure
  could not be read as numbers.
- The JK BMS: its supply range, its delays, whether its limits can be set as the docs ask, and how it wakes.
  One seller's page lists 4S to 8S and 100 A; nothing else.
- The INJS235's stall current, the UBEC's output plug and voltage selector, the FSESC's connectors and pin
  order, and the motor's sensor plug.
- Every DigiKey price and stock figure. I checked the arithmetic and six part sizes, not the cart.
- The bank figures, and what the three pending debits were for.
- The mechanical fit of anything. I used the 23 mm limit in `mech/kit.py` as given.
- `sim/` and the aero work. Not opened, as asked.

What I ran: the two pytest suites (cache writing off for the second; the first refreshed git-ignored
`__pycache__` files), and four short scripts of my own kept outside the repository.
