AtlasAutoware/car1v2/sim/perf/out/summary.md

| pinion / spur | overall ratio | top speed: worst case | nominal | best case | launch force at 60 A | grip at mu 0.8 | motor rpm at 13.5 m/s |
| --- | ---: | ---: | ---: | ---: | ---: | ---: | ---: |
| 13 / 54 | 11.84 | 13.6 m/s | 14.5 m/s | 15.9 m/s | 47.9 N | 40.4 N | 27,875 |
| 14 / 54 | 10.99 | 14.5 m/s | 15.6 m/s | 17.1 m/s | 44.4 N | 40.4 N | 25,884 |
| 15 / 54 | 10.26 | 15.3 m/s | 16.6 m/s | 18.2 m/s | 41.5 N | 40.4 N | 24,158 |
| 16 / 54 | 9.62 | 16.2 m/s | 17.5 m/s | 19.3 m/s | 38.9 N | 40.4 N | 22,649 |

| straight between two 5 m/s corners | 8 m | 10 m | 12 m | 14 m | 16 m | 18 m | 20 m | 22 m | 25 m | 30 m |
| --- | ---: | ---: | ---: | ---: | ---: | ---: | ---: | ---: | ---: | ---: |
| reference car | 9.3 | 10.1 | 10.9 | 11.5 | 12.1 | 12.6 | 13.1 | 13.6 | 14.2 | 15.2 |
| car 1 v2, regen 12 A | 9.1 | 9.8 | 10.3 | 10.9 | 11.4 | 11.9 | 12.3 | 12.8 | 13.3 | 14.2 |
| car 1 v2, regen 30 A | 9.3 | 10.2 | 10.9 | 11.6 | 12.2 | 12.8 | 13.4 | 14.0 | 14.7 | 15.4 |
| car 1 v2, regen 30 A, capped at 13.5 | 9.3 | 10.2 | 10.9 | 11.6 | 12.2 | 12.8 | 13.4 | 13.5 | 13.5 | 13.5 |

**team comp_track race line (243 m)**

| car | lap | top speed | average |
| --- | ---: | ---: | ---: |
| reference car | 35.91 s | 15.97 m/s | 6.78 m/s |
| car 1 v2, regen 12 A | 36.21 s | 15.04 m/s | 6.72 m/s |
| car 1 v2, regen 30 A | 35.86 s | 15.93 m/s | 6.79 m/s |
| car 1 v2, regen 30 A, capped at 13.5 | 35.97 s | 13.5 m/s | 6.77 m/s |
| reference car, mu 0.6 | 41.41 s | 14.71 m/s | 5.88 m/s |
| car 1 v2, regen 30 A, mu 0.6 | 41.39 s | 14.81 m/s | 5.88 m/s |
| reference car, mu 1.05 | 31.6 s | 16.55 m/s | 7.7 m/s |
| car 1 v2, regen 30 A, mu 1.05 | 31.69 s | 16.21 m/s | 7.68 m/s |
| car 1 v2, regen 30 A, 4.54 kg | 35.86 s | 16.04 m/s | 6.79 m/s |
| car 1 v2, regen 30 A, 5.76 kg | 35.93 s | 15.78 m/s | 6.78 m/s |

**box, 26 x 9 m centre line (66 m)**

| car | lap | top speed | average |
| --- | ---: | ---: | ---: |
| reference car | 9.67 s | 13.18 m/s | 6.79 m/s |
| car 1 v2, regen 12 A | 9.8 s | 12.35 m/s | 6.7 m/s |
| car 1 v2, regen 30 A | 9.66 s | 13.47 m/s | 6.8 m/s |
| car 1 v2, regen 30 A, capped at 13.5 | 9.66 s | 13.47 m/s | 6.8 m/s |
| reference car, mu 0.6 | 11.16 s | 11.64 m/s | 5.89 m/s |
| car 1 v2, regen 30 A, mu 0.6 | 11.15 s | 11.66 m/s | 5.89 m/s |
| reference car, mu 1.05 | 8.55 s | 14.04 m/s | 7.68 m/s |
| car 1 v2, regen 30 A, mu 1.05 | 8.67 s | 14.26 m/s | 7.58 m/s |
| car 1 v2, regen 30 A, 4.54 kg | 9.66 s | 13.46 m/s | 6.8 m/s |
| car 1 v2, regen 30 A, 5.76 kg | 9.75 s | 13.18 m/s | 6.74 m/s |
