AtlasAutoware/car1v2/boards/power/out/render/power_iso.png

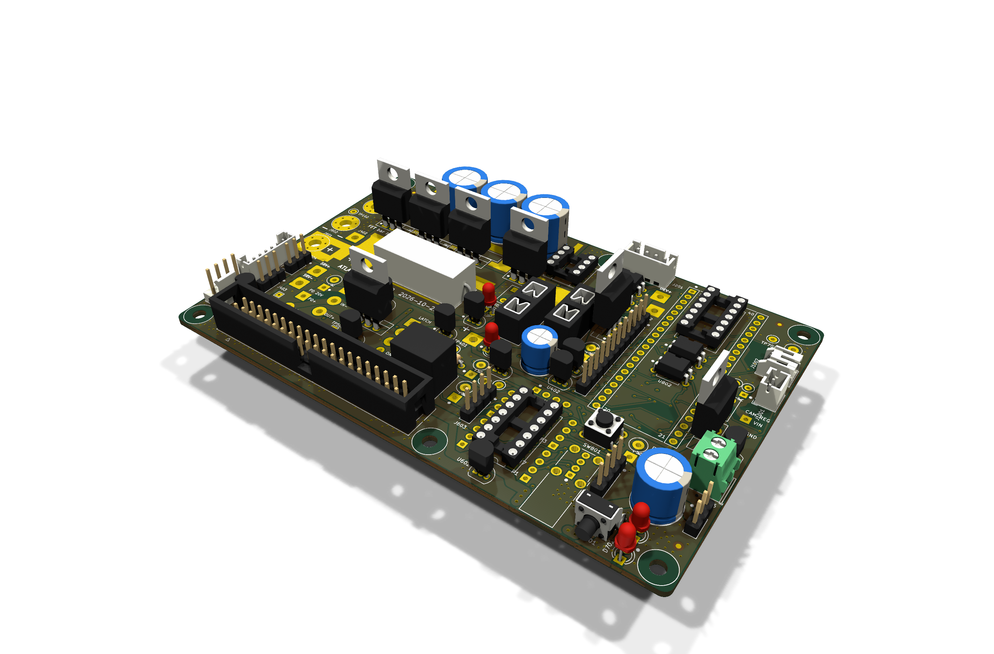
boards/power/out/render/power_iso.png
