AtlasAutoware/car1v2/boards/power/out/render/power_top.png

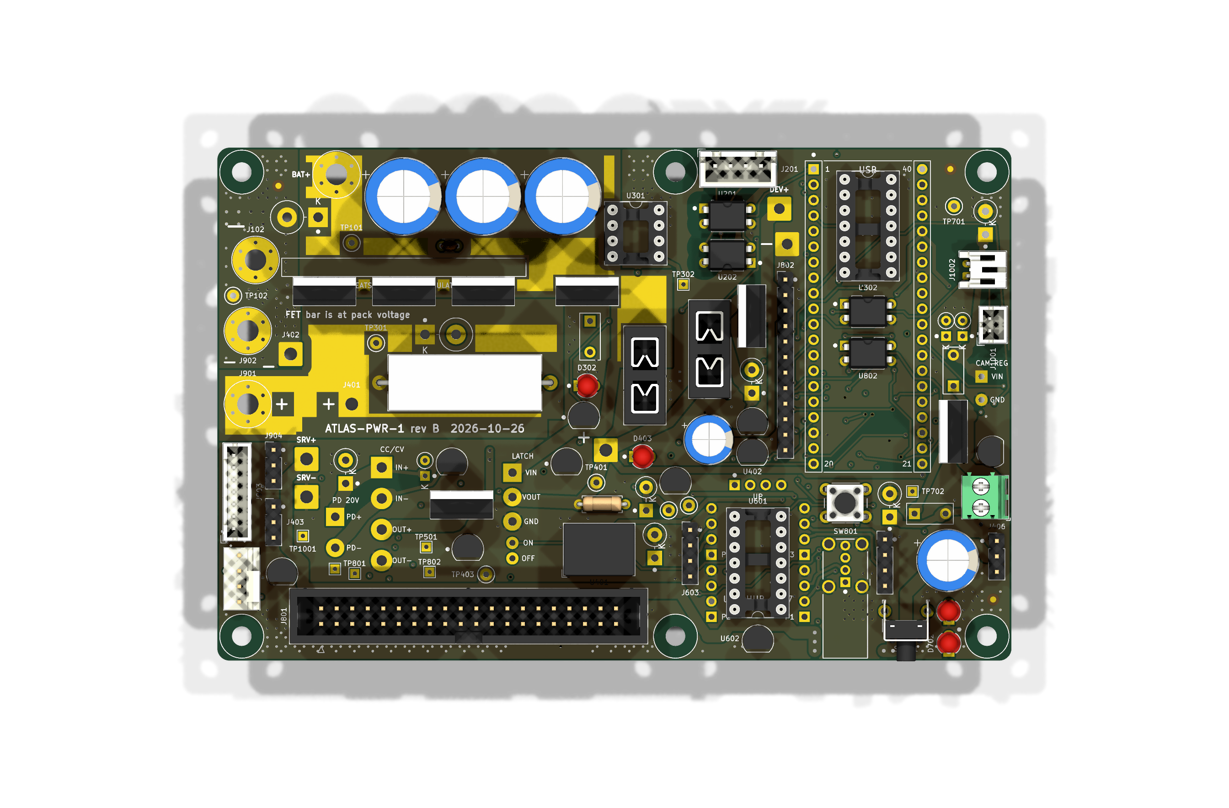
boards/power/out/render/power_top.png
