AtlasAutoware/car1v2/share/car1v2_car_exploded.png

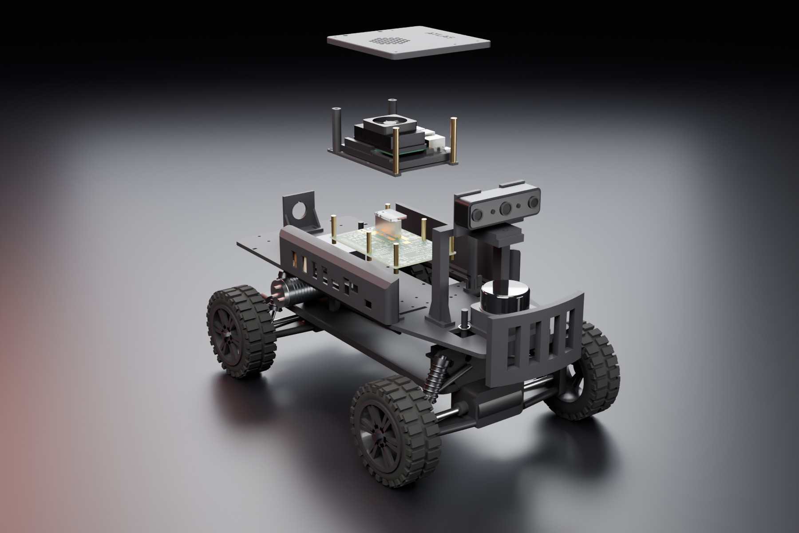
share/car1v2_car_exploded.png
