AtlasAutoware/car1v2/share/car1v2_car_rear_right.png

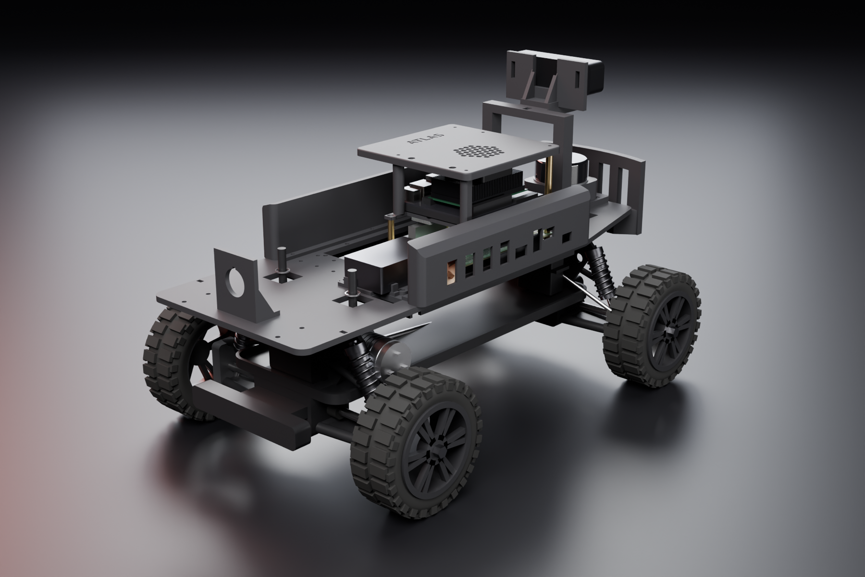
share/car1v2_car_rear_right.png
