AtlasAutoware/car1v2/share/car1v2_car_side.png

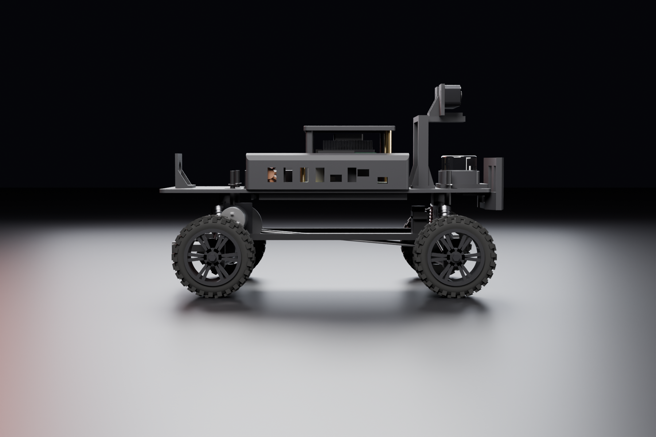
share/car1v2_car_side.png
