AtlasAutoware/car1v2/share/car1v2_car_top.png

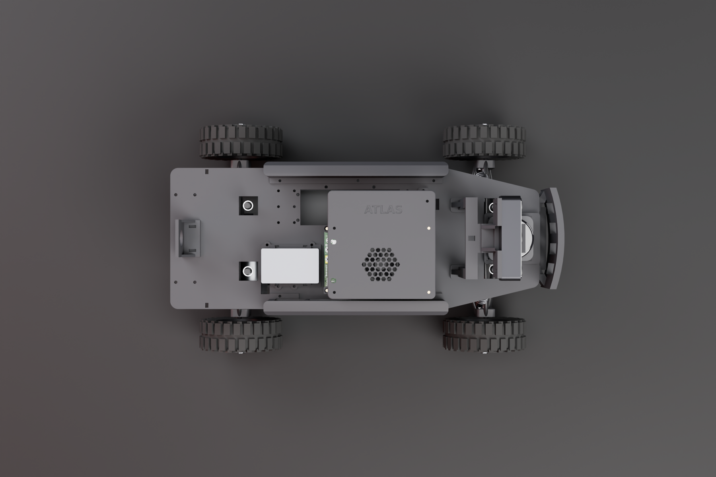
share/car1v2_car_top.png
