AtlasAutoware/car1v2/bom/revb/power_board_cost.md

# ATLAS-PWR-1 rev B: parts cost per board

Generated by `bom/revb/make_power_bom.py` from `boards/power/atlas_power_parts.json`. Prices are USD at
quantity 1 on 2026-10-24; buying for three boards at once lowers the chip resistors and capacitors to a
few cents each. The bare PCB is quoted separately (PCBWay, agent E). Cables, the BMS, the Castle BEC and
the pack hardware are car-level items in the main cost table.

| Block | Parts cost (USD) | Of which not verified (USD) |
| --- | ---: | ---: |
| A pack input | 5.83 | 0.00 |
| B BMS link | 1.49 | 0.00 |
| C main switch, precharge, E-stop gate | 24.75 | 2.50 |
| D latch and rails (5 V, servo, dev kit, lidar, camera) | 61.08 | 0.00 |
| E USB-C charging | 20.94 | 8.00 |
| F debug hub and console | 18.38 | 0.30 |
| G Pico supervisor | 8.80 | 0.50 |
| H Jetson ribbon and J14 | 4.04 | 0.00 |
| I ESC interface | 1.06 | 0.00 |
| J E-stop, fan, holes | 3.03 | 0.00 |
| **Total per board** | **149.40** | **11.30** |

| Assembly class | Parts |
| --- | ---: |
| through-hole | 80 |
| SMD 1206/1210, bottom | 104 |
| module on sockets | 2 |
| module off board, wired | 4 |
| mechanical | 1 |

77 BOM lines; DNP parts are listed in the CSV with quantity 0.
