AtlasAutoware/car1v2/bom/car1v2/cart_digikey.csv

action | digikey_pn | mfr_pn | what | qty | unit_usd | line_usd | digikey_tariff_estimate_usd | availability_2026-11-09 | for
keep | 36-5000-ND | 5000 | Keystone test point, red | 10 | 0.2630 | 2.63 | 0.40 | in stock | TP101 TP102 TP301 TP401-403 TP701 TP1002 + 2
keep | 455-B4B-XH-A-ND | B4B-XH-A | JST XH header 4 pos | 2 | 0.1700 | 0.34 | 0.10 | in stock | J201 + 1
keep | PC817X2NSZ9F-ND | PC817X2NSZ9F | optocoupler DIP-4 | 6 | 0.3300 | 1.98 | 0.99 | in stock | U201 U202 U801 U802 + 2
keep | 448-IRFB7430PBF-ND | IRFB7430PBF | main switch FET 40 V TO-220 | 4 | 3.6900 | 14.76 | 5.54 | in stock | Q301-Q303 + 1
keep | 576-1234-ND | MIC5014YN | high-side gate driver DIP-8 | 2 | 3.5400 | 7.08 | 0.00 | in stock | U301 + 1
delete | 490-6544-2-ND | GRM32ER71H106KA12L | 10 uF 50 V X7R 1210, reel packaging | 7 | 0.0000 | 0.00 | 0.00 | BACKORDER | C301 C402 C403 C501 C702
keep | 296-1606-5-ND | SN74HCT08N | quad AND DIP-14 | 2 | 0.9300 | 1.86 | 0.00 | in stock | U302 + 1
keep | IRF9Z34NPBF-ND | IRF9Z34NPBF | P-FET 55 V TO-220 | 3 | 2.1300 | 6.39 | 0.00 | in stock | Q304 Q405 + 1
keep | 2N3904FS-ND | 2N3904BU | NPN TO-92 | 10 | 0.1790 | 1.79 | 0.45 | in stock | Q305 Q401 Q403 Q406 Q502 Q503 + 4
keep | MF-R050-ND | MF-R050 | polyfuse 0.5 A | 2 | 0.4700 | 0.94 | 0.26 | in stock | F301 + 1
keep | 10W-5-ND | SQP500JB-10R | 10 ohm 5 W cement | 2 | 0.7100 | 1.42 | 0.50 | in stock | R313 + 1
keep | BC2301-ND | NTCLE100E3103JB0 | 10k NTC | 2 | 0.6100 | 1.22 | 0.12 | in stock | TH301 + 1
keep | 160-1139-ND | LTL-4221N | LED red 3 mm | 4 | 0.1900 | 0.76 | 0.05 | backorder, due 2026-11-16 | D302 D702 + 2
keep | 945-2201-ND | R-78E5.0-1.0 | 5 V 1 A switching regulator | 1 | 4.5100 | 4.51 | 1.13 | in stock | U401
keep | 160-1142-ND | LTL-4231N | LED green 3 mm | 4 | 0.1900 | 0.76 | 0.06 | in stock | D403 D701 + 2
keep | 732-5316-ND | 61300311121 | pin header 1x3 | 4 | 0.1300 | 0.52 | 0.06 | in stock | J403 J406 J904 + 1
delete | P14398-ND | EEU-FR1C102 | 1000 uF 16 V | 2 | 1.0800 | 2.16 | 0.16 | BACKORDER (past due) | C404
keep | 36-3568-ND | 3568 | mini blade fuse holder | 2 | 1.3100 | 2.62 | 0.00 | in stock | F401 F501
keep | IRF4905PBF-ND | IRF4905PBF | P-FET 55 V 74 A TO-220 | 3 | 3.2600 | 9.78 | 3.67 | in stock | Q402 Q501 + 1
delete | P124227-ND | EEU-FR1V221 | 220 uF 35 V | 2 | 0.7100 | 1.42 | 0.11 | BACKORDER to 2027-01-29 | C405
keep | MF-R075-ND | MF-R075 | polyfuse 0.75 A | 3 | 0.4700 | 1.41 | 0.41 | in stock | F402 F403 + 1
keep | 277-1721-ND | 1984617 | Phoenix terminal block 2 pos | 1 | 0.5900 | 0.59 | 0.25 | in stock | J409
keep | 732-2731-ND | 614004134726 | USB-A receptacle | 1 | 3.6800 | 3.68 | 1.10 | in stock | J601
keep | 732-5317-ND | 61300411121 | pin header 1x4 | 3 | 0.1800 | 0.54 | 0.08 | in stock | J602 J603 + 1
keep | MCP2221A-I/P-ND | MCP2221A-I/P | USB to UART DIP-14 | 1 | 3.2000 | 3.20 | 0.00 | in stock | U601
keep | MCP1700-3302E/TO-ND | MCP1700-3302E/TO | 3.3 V LDO TO-92 | 2 | 0.5000 | 1.00 | 0.01 | in stock | U602 + 1
keep | 732-5401-ND | 61204021621 | box header 2x20 | 1 | 1.1500 | 1.15 | 0.16 | in stock | J801
keep | 732-5323-ND | 61301211121 | pin header 1x12 | 2 | 0.5400 | 1.08 | 0.15 | in stock | J802 + 1
keep | CKN9092-ND | PTS645SL50-2 LFS | tactile switch 6 mm | 2 | 0.2800 | 0.56 | 0.24 | in stock | SW801 + 1
keep | 455-1709-ND | B7B-PH-K-S | JST PH header 7 pos | 2 | 0.3300 | 0.66 | 0.07 | in stock | J903 + 1
keep | 455-1704-ND | B2B-PH-K-S | JST PH header 2 pos | 2 | 0.1200 | 0.24 | 0.02 | in stock | J1001 + 1
keep | 455-1719-ND | S2B-PH-K-S | JST PH header 2 pos, side entry | 2 | 0.1200 | 0.24 | 0.00 | in stock | J1002 + 1
keep | WM4330-ND | 0470531000 | fan header 4 pos | 1 | 0.5600 | 0.56 | 0.00 | in stock | J1003
keep | 2N7000-G-ND | 2N7000-G | N-FET TO-92 | 2 | 0.5000 | 1.00 | 0.05 | in stock | Q1001 + 1
keep | A120347-ND | 1-2199298-2 | DIP-8 socket | 2 | 0.2700 | 0.54 | 0.16 | in stock | U301 socket + 1
keep | A120348-ND | 1-2199298-3 | DIP-14 socket | 3 | 0.2800 | 0.84 | 0.25 | in stock | U302 U601 sockets + 1
keep | S7018-ND | PPTC201LFBN-RC | socket strip 1x20 | 2 | 1.1400 | 2.28 | 0.00 | in stock | Pico sockets
keep | S7006-ND | PPTC081LFBN-RC | socket strip 1x8 | 2 | 0.5800 | 1.16 | 0.00 | in stock | hub module sockets
keep | S7002-ND | PPTC041LFBN-RC | socket strip 1x4 | 1 | 0.4200 | 0.42 | 0.00 | in stock | hub module socket
keep | 2648-SC0917-ND | SC0917 | Raspberry Pi Pico H (headers fitted) | 2 | 5.0000 | 10.00 | 0.34 | in stock | MOD701 + 1 spare
keep | 839-10-01779-ND | 10-01779 | Tensility 5.5 x 2.5 mm right-angle DC lead | 1 | 4.5100 | 4.51 | 3.32 | in stock | dev-kit power lead
keep | 311-4.70KFRCT-ND | RC1206FR-074K7L | 4.7k 1206 | 10 | 0.0530 | 0.53 | 0.04 | in stock | 7 used
keep | 311-470FRCT-ND | RC1206FR-07470RL | 470 1206 | 10 | 0.0530 | 0.53 | 0.04 | in stock | 5 used
keep | 311-10.0FRCT-ND | RC1206FR-0710RL | 10 ohm 1206 | 10 | 0.0860 | 0.86 | 0.08 | in stock | 3 used
keep | 311-2.20MFRCT-ND | RC1206FR-072M2L | 2.2M 1206 | 10 | 0.0560 | 0.56 | 0.04 | in stock | 1 used
keep | 311-100KFRCT-ND | RC1206FR-07100KL | 100k 1206 | 25 | 0.0404 | 1.01 | 0.08 | in stock | 17 used
keep | 311-10.0KFRCT-ND | RC1206FR-0710KL | 10k 1206 | 30 | 0.0404 | 1.21 | 0.09 | in stock | 21 used
keep | 311-33.0KFRCT-ND | RC1206FR-0733KL | 33k 1206 | 10 | 0.0530 | 0.53 | 0.04 | in stock | 1 used
keep | 311-22.0KFRCT-ND | RC1206FR-0722KL | 22k 1206 | 10 | 0.0530 | 0.53 | 0.04 | in stock | 1 used
keep | 311-2.20KFRCT-ND | RC1206FR-072K2L | 2.2k 1206 | 10 | 0.0530 | 0.53 | 0.04 | backorder, due 2026-11-23 | 1 used
keep | 311-220FRCT-ND | RC1206FR-07220RL | 220 1206 | 10 | 0.0530 | 0.53 | 0.04 | in stock | 1 used
keep | 311-6.80KFRCT-ND | RC1206FR-076K8L | 6.8k 1206 | 10 | 0.0560 | 0.56 | 0.04 | in stock | 2 used
keep | 311-15.0KFRCT-ND | RC1206FR-0715KL | 15k 1206 | 10 | 0.0530 | 0.53 | 0.04 | in stock | 1 used
keep | 311-1.20MFRCT-ND | RC1206FR-071M2L | 1.2M 1206 | 10 | 0.0530 | 0.53 | 0.04 | in stock | 1 used
keep | 311-47.0KFRCT-ND | RC1206FR-0747KL | 47k 1206 | 10 | 0.0530 | 0.53 | 0.04 | in stock | 4 used
keep | 311-2.20FRCT-ND | RC1206FR-072R2L | 2.2 ohm 1206 | 10 | 0.0910 | 0.91 | 0.08 | in stock | 1 used
keep | 311-18.0KFRCT-ND | RC1206FR-0718KL | 18k 1206 | 10 | 0.0530 | 0.53 | 0.04 | in stock | 2 used
keep | 311-3.30FRCT-ND | RC1206FR-073R3L | 3.3 ohm 1206 | 10 | 0.0860 | 0.86 | 0.14 | backorder, past due (was due 2026-11-09) | 2 used
keep | 311-100FRCT-ND | RC1206FR-07100RL | 100 ohm 1206 | 10 | 0.0530 | 0.53 | 0.04 | in stock | 2 used
keep | 1276-1017-1-ND | CL31B104KBCNNNC | 100 nF 50 V X7R 1206 | 20 | 0.0800 | 1.60 | 0.04 | in stock | 13 used
keep | 1.5KE20ALFCT-ND | 1.5KE20A | TVS 17.1 V 1500 W | 2 | 1.0600 | 2.12 | 0.73 | in stock | D101 + 1
keep | 1.5KE22ALFCT-ND | 1.5KE22A | TVS 18.8 V 1500 W | 2 | 1.0600 | 2.12 | 0.74 | in stock | D301 + 1
keep | P6KE20ALFCT-ND | P6KE20A | TVS 17.1 V 600 W | 2 | 0.7000 | 1.40 | 0.49 | in stock | D401 + 1
keep | P6KE22ALFCT-ND | P6KE22A | TVS 18.8 V 600 W | 4 | 0.7000 | 2.80 | 1.22 | in stock | D404-D406 + 1
keep | P6KE24ALFCT-ND | P6KE24A | TVS 20.5 V 600 W | 2 | 0.7000 | 1.40 | 0.49 | in stock | D501 + 1
keep | 1N5817RLGOSCT-ND | 1N5817RLG | Schottky 20 V 1 A | 2 | 0.6700 | 1.34 | 0.34 | in stock | D402 + 1
keep | 2N3906FS-ND | 2N3906BU | PNP TO-92 | 2 | 0.2800 | 0.56 | 0.14 | in stock | Q404 + 1
delete | P14443-ND | EEU-FR1V681L | WRONG PART: 680 uF 35 V in a 10 x 25 mm can, 27 mm seated; the dev-kit tray allows 23 mm (review B1) | 4 | 1.4600 | 5.84 | 0.44 | in stock | -
keep | 399-C1206C103K5RACTUCT-ND | C1206C103K5RACTU | 10 nF 50 V X7R 1206 | 10 | 0.1240 | 1.24 | 0.09 | in stock | 1 used
keep | 311-1.00KFRCT-ND | RC1206FR-071KL | 1k 1206 | 25 | 0.0404 | 1.01 | 0.08 | in stock | 9 used
delete | 1276-1066-1-ND | CL21B105KAFNNNE | WRONG PART: 1 uF 25 V in 0805, added by mistake | 5 | 0.1100 | 0.55 | 0.05 | BACKORDER | -
keep | BAT85S-TAPCT-ND | BAT85S-TAP | Schottky 30 V DO-35 | 4 | 0.5000 | 2.00 | 0.74 | in stock | D1001 D1002 + 2
keep | F989-ND | 0297005.WXNV | mini blade fuse 5 A | 3 | 0.3900 | 1.17 | 0.20 | in stock | F401 F501 + 1
delete | P14397-ND | EEU-FR1C102L | WRONG PART: 1000 uF 16 V in an 8 mm can with 3.5 mm lead spacing; C404 has 5.0 mm holes (review B1) | 2 | 0.9400 | 1.88 | 0.19 | in stock | -
keep | 399-C1206C105K5RACTUCT-ND | C1206C105K5RACTU | 1 uF 50 V X7R 1206 (replaces TDK C3216X7R1H105K160AB: 0 in stock, due 2027-03-29) | 5 | 0.4600 | 2.30 |  | in stock | C104 C603 C604 + 2
keep | 1528-5997-ND | 5997 | Adafruit CH334F 4-port USB hub | 1 | 4.9500 | 4.95 |  | in stock | MOD601
keep | 2183-2813-ND | 2813 | Pololu pushbutton power switch | 1 | 10.1400 | 10.14 |  | ships in about 1 day | MOD401
delete | 1528-1988-ND | 3142 | WRONG PART: Adafruit jumper wires, added by mistake for the ribbon cable | 1 | 3.9500 | 3.95 |  | in stock | -
phase2 | 1528-5807-ND | 5807 | Adafruit HUSB238 USB-C PD trigger | 1 | 5.9500 | 5.95 |  | in stock | MOD501 (USB-C charging)
keep | P12417-ND | EEU-FM1V681 | 680 uF 35 V, 12.5 mm can, 22 mm seated, 5.0 mm pitch (replaces EEU-FR1V681L; FM series, ripple rating not compared) | 4 | 1.4700 | 5.88 |  | in stock: 1,548 | C101 C102 C103 + 1
keep | P12366-ND | EEU-FM1C102 | 1000 uF 16 V, 10 mm can, 22 mm seated, 5.0 mm pitch (replaces EEU-FR1C102L) | 2 | 1.0700 | 2.14 |  | in stock: 2,715 | C404 + 1
keep | 1276-3387-1-ND | CL32B106KBJNNNE | 10 uF 50 V X7R 1210, cut tape (replaces the backordered Murata part) | 10 | 0.4280 | 4.28 |  | in stock: 573,447 | C301 C402 C403 C501 C702 + 5
keep | P12408-ND | EEU-FM1V151 | 150 uF 35 V, 8 mm can, 13 mm seated, 3.5 mm pitch. A VALUE CHANGE for C405 (was 220 uF): no 220 uF 35 V part in an 8 mm can was in stock | 2 | 0.5800 | 1.16 |  | in stock: 32,224 | C405 + 1
add by hand |  |  | TL431 in TO-92 with straight leads (TI TL431ACLP) | 2 | 0.50 | 1.00 |  | not in the cart (est) | U402 + 1; 0.14 at Mouser on 2026-10-24. Not the formed-lead TL431ACLPRE3
add by hand |  |  | 1N5247B 17 V zener, DO-35 | 2 | 0.17 | 0.34 |  | not in the cart (quote) | D502 + 1; Mouser 2026-10-24
add by hand |  |  | 4.7 ohm 0.6 W metal film axial (Vishay MBB02070C4708FCT00) | 2 | 0.26 | 0.52 |  | not in the cart (quote) | R408 + 1; Mouser 2026-10-24
add by hand |  |  | C&K PTS645VL58-2 LFS right-angle tactile switch, or another PTS645V right-angle part | 2 | 0.33 | 0.66 |  | not in the cart (est) | SW401 + 1; the price is Mouser's through an aggregator, where it showed 0 in stock on 2026-11-09. Not checked at DigiKey
