AtlasAutoware/car1v2/bom/car1v2/cart_sensor_upgrade.csv

supplier | what | qty | unit_usd | line_usd | basis | note
DigiKey or Pololu | Pololu S18V20F12 12 V regulator for the Triton (MOD402) | 1 | 29.95 | 29.95 | quote | Pololu page 2026-10-24
LUCID | GPIO-M8-5M-RA2-A camera power cable | 1 | 40.00 | 40.00 | quote | 2026-10-24
ZimaSpace | USB 3 gigabit Ethernet adapter (RTL8153) for the lidar | 1 | 9.90 | 9.90 | quote | sale price 2026-10-24; list 15.90
