AtlasAutoware/car1v2/mech/out/car1v2/dxf/estop_plate.dxf

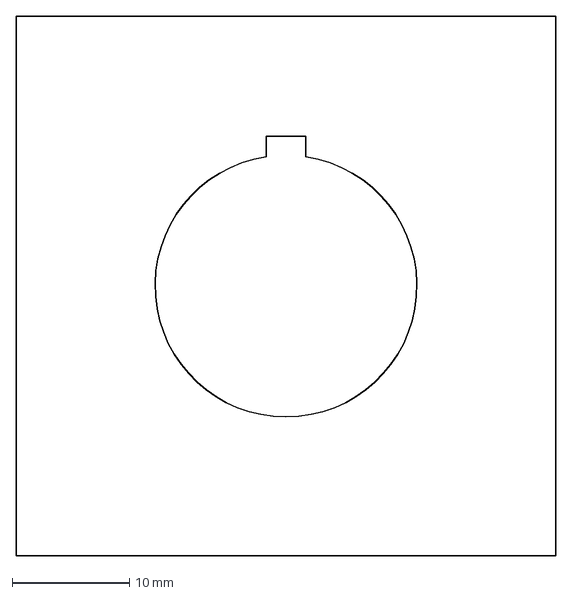
[picture p10: CAD file, 2026-11-09]
mech/out/car1v2/dxf/estop_plate.dxf
46.0 x 46.0 mm
