AtlasAutoware/car1v2/mech/out/car1v2/step/bms_fence_jk.step

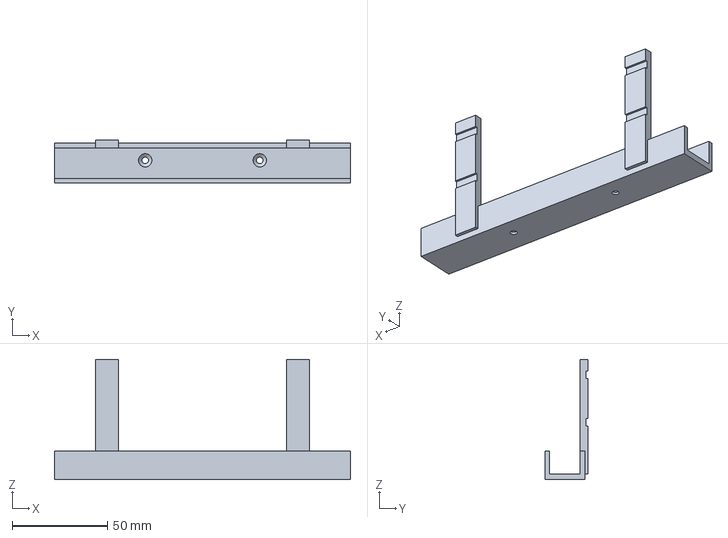
[picture p11: CAD file, 2026-11-09]
mech/out/car1v2/step/bms_fence_jk.step
155.0 x 22.6 x 63.0 mm
