AtlasAutoware/car1v2/sim/aero/out/geom/wing_m20.stl

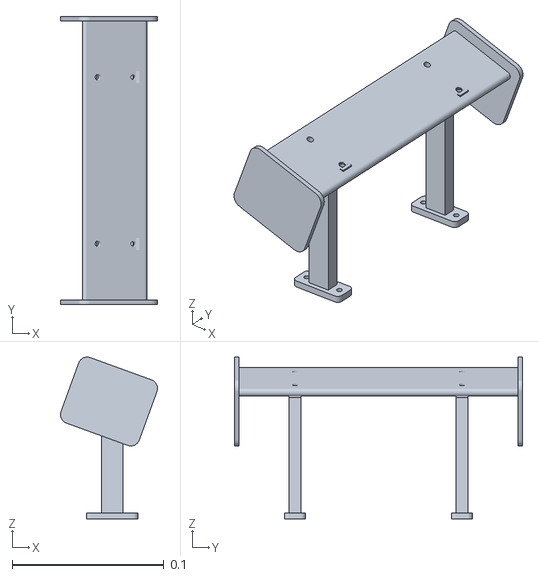
[picture p12: CAD file, 2026-11-09]
sim/aero/out/geom/wing_m20.stl
0.064 x 0.19 x 0.107
