AtlasAutoware/car1v2/sim/aero/out/step/car1v2_aero_no_wing.step

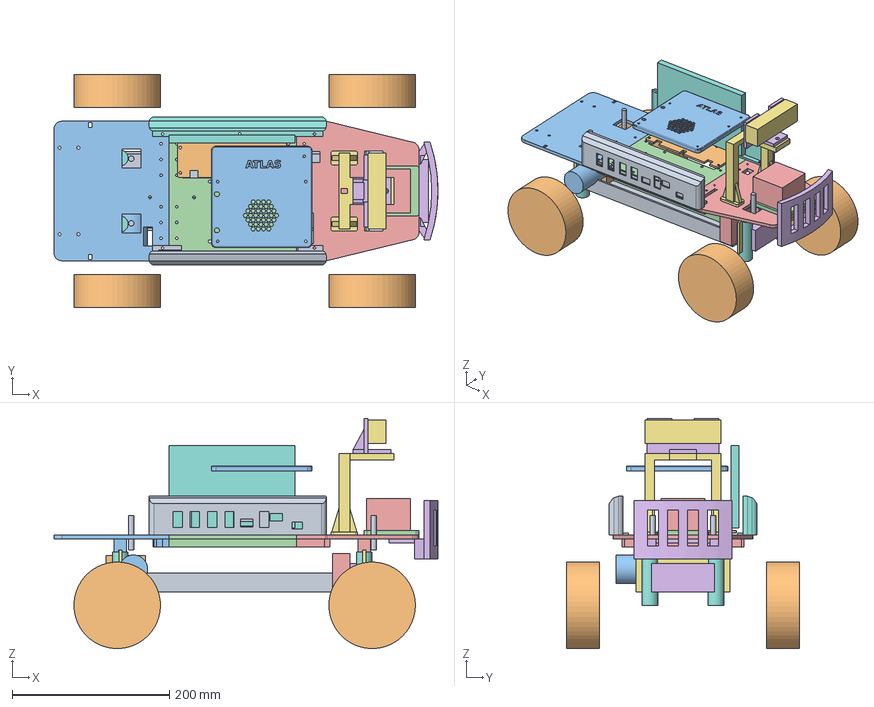
[picture p13: CAD file, 2026-11-09]
sim/aero/out/step/car1v2_aero_no_wing.step
488.0 x 296.0 x 292.3 mm
