AtlasAutoware/car1v2/mech/out/car1v2/dxf/c1_plinth_plan.dxf

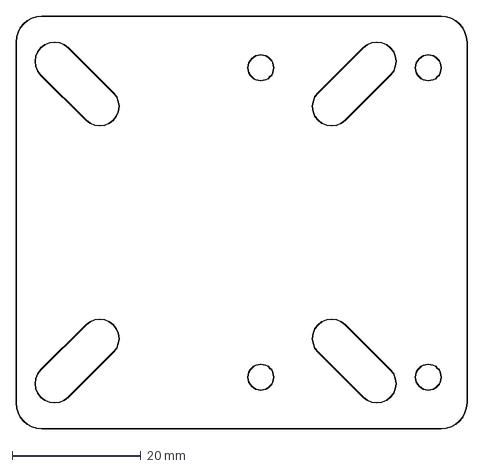
[picture p14: CAD file, 2026-11-09]
mech/out/car1v2/dxf/c1_plinth_plan.dxf
70.0 x 64.0 mm
