AtlasAutoware/car1v2/mech/out/car1v2/step/c1_plinth.step

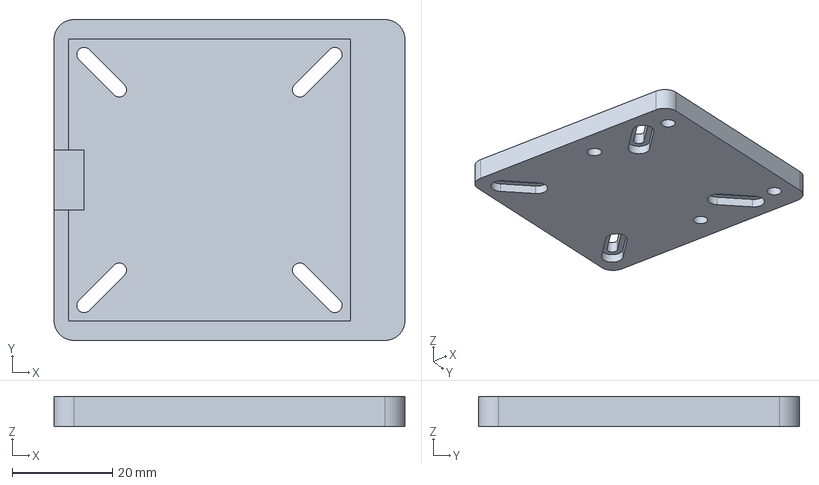
[picture p15: CAD file, 2026-11-09]
mech/out/car1v2/step/c1_plinth.step
70.0 x 64.0 x 6.00 mm
