AtlasAutoware/car1v2/sim/aero/out/geom/body.stl

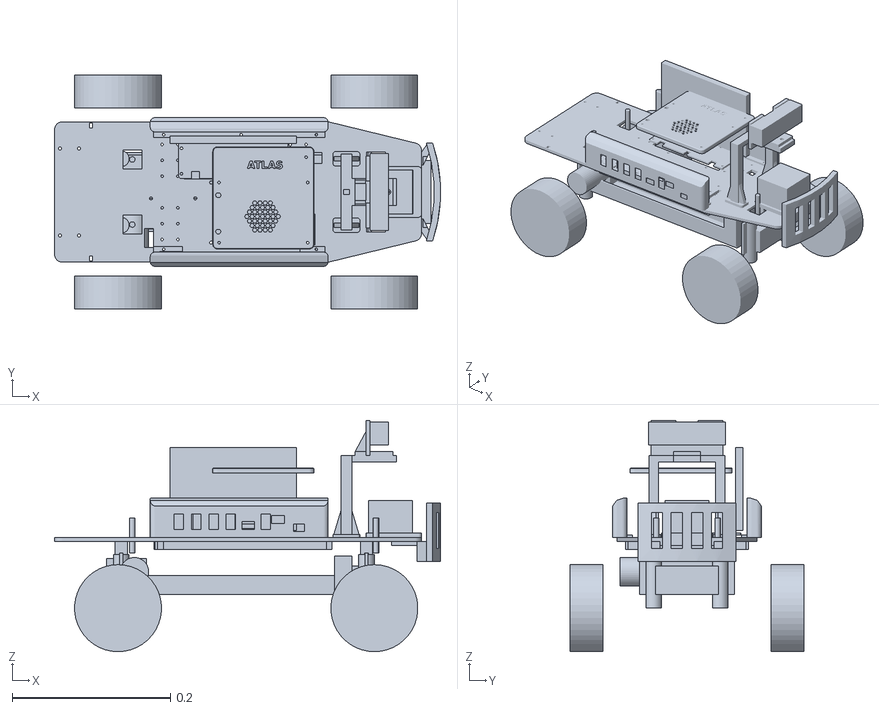
[picture p16: CAD file, 2026-11-09]
sim/aero/out/geom/body.stl
0.488 x 0.296 x 0.292
