AtlasAutoware/car1v2/sim/aero/out/step/car1v2_aero_wing_0.step

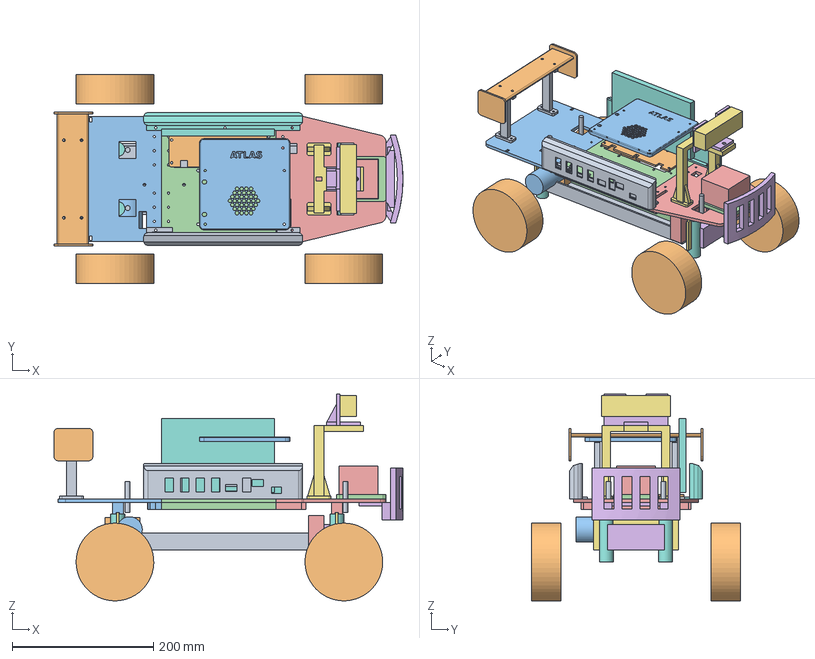
[picture p17: CAD file, 2026-11-09]
sim/aero/out/step/car1v2_aero_wing_0.step
494.0 x 296.0 x 292.3 mm
