AtlasAutoware/car1v2/mech/out/car1v2/step/oakd_cradle.step

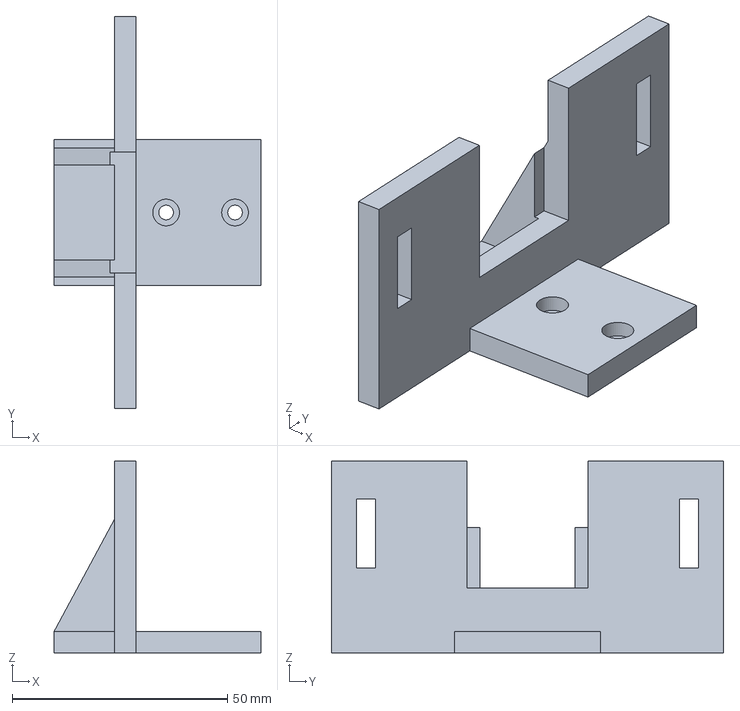
[picture p18: CAD file, 2026-11-09]
mech/out/car1v2/step/oakd_cradle.step
48.0 x 91.0 x 44.5 mm
