AtlasAutoware/car1v2/sim/aero/out/geom/wing_0.stl

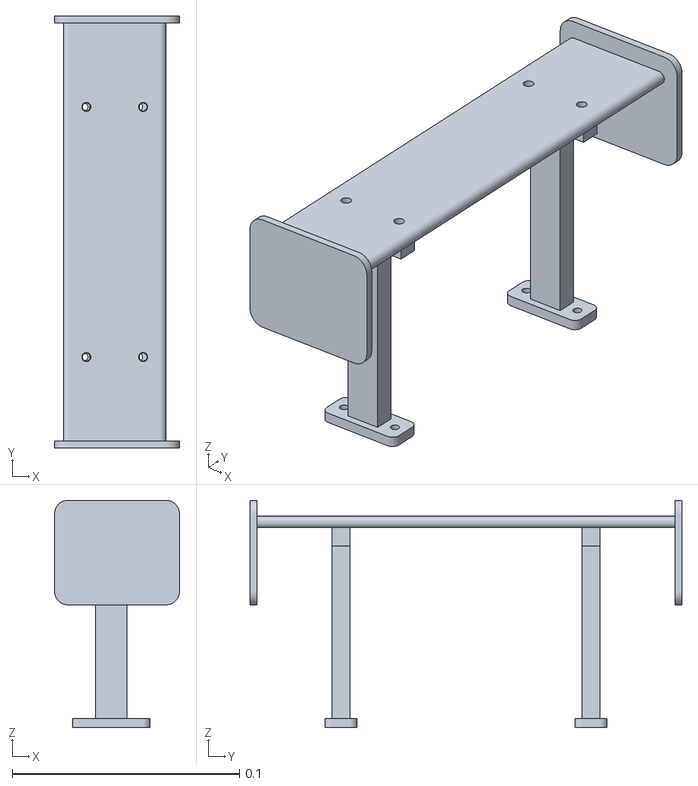
[picture p19: CAD file, 2026-11-09]
sim/aero/out/geom/wing_0.stl
0.055 x 0.19 x 0.1
