AtlasAutoware/car1v2/mech/out/car1v2/step/estop_bracket.step

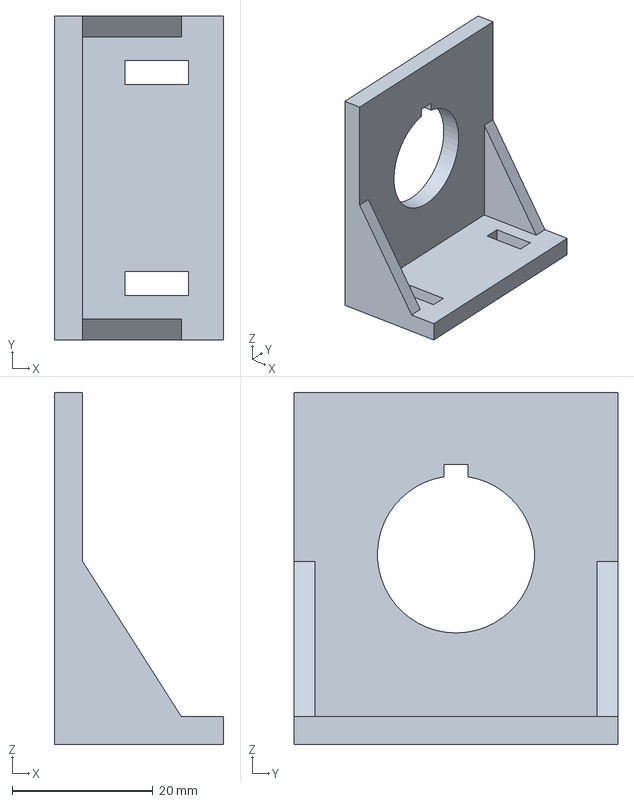
[picture p20: CAD file, 2026-11-09]
mech/out/car1v2/step/estop_bracket.step
24.0 x 46.0 x 50.0 mm
