AtlasAutoware/car1v2/sim/aero/out/geom/wing_m12.stl

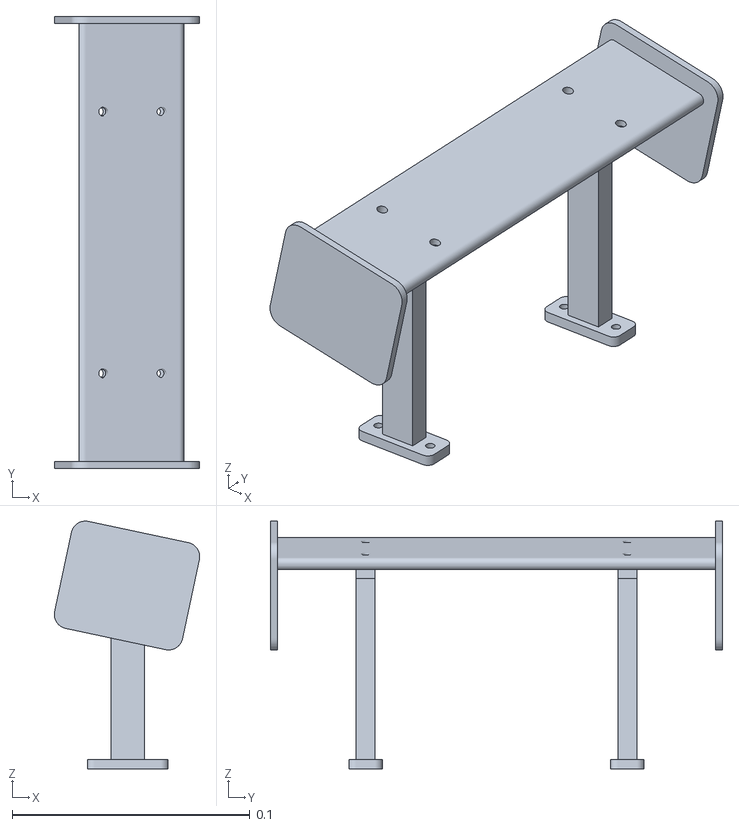
[picture p21: CAD file, 2026-11-09]
sim/aero/out/geom/wing_m12.stl
0.0611 x 0.19 x 0.104
