AtlasAutoware/car1v2/(list of files, cad)

Other CAD files:
mech/out/car1v2/3mf/bms_fence_jk.3mf
mech/out/car1v2/3mf/c1_plinth.3mf
mech/out/car1v2/3mf/estop_bracket.3mf
mech/out/car1v2/3mf/oakd_cradle.3mf
mech/out/car1v2/stl/bms_fence_jk.stl
mech/out/car1v2/stl/c1_plinth.stl
mech/out/car1v2/stl/estop_bracket.stl
mech/out/car1v2/stl/oakd_cradle.stl
