AtlasAutoware/car1v2/boards/power/atlas_power.kicad_pcb

## KiCad design boards/power/atlas_power.kicad_pcb (2026-11-09)

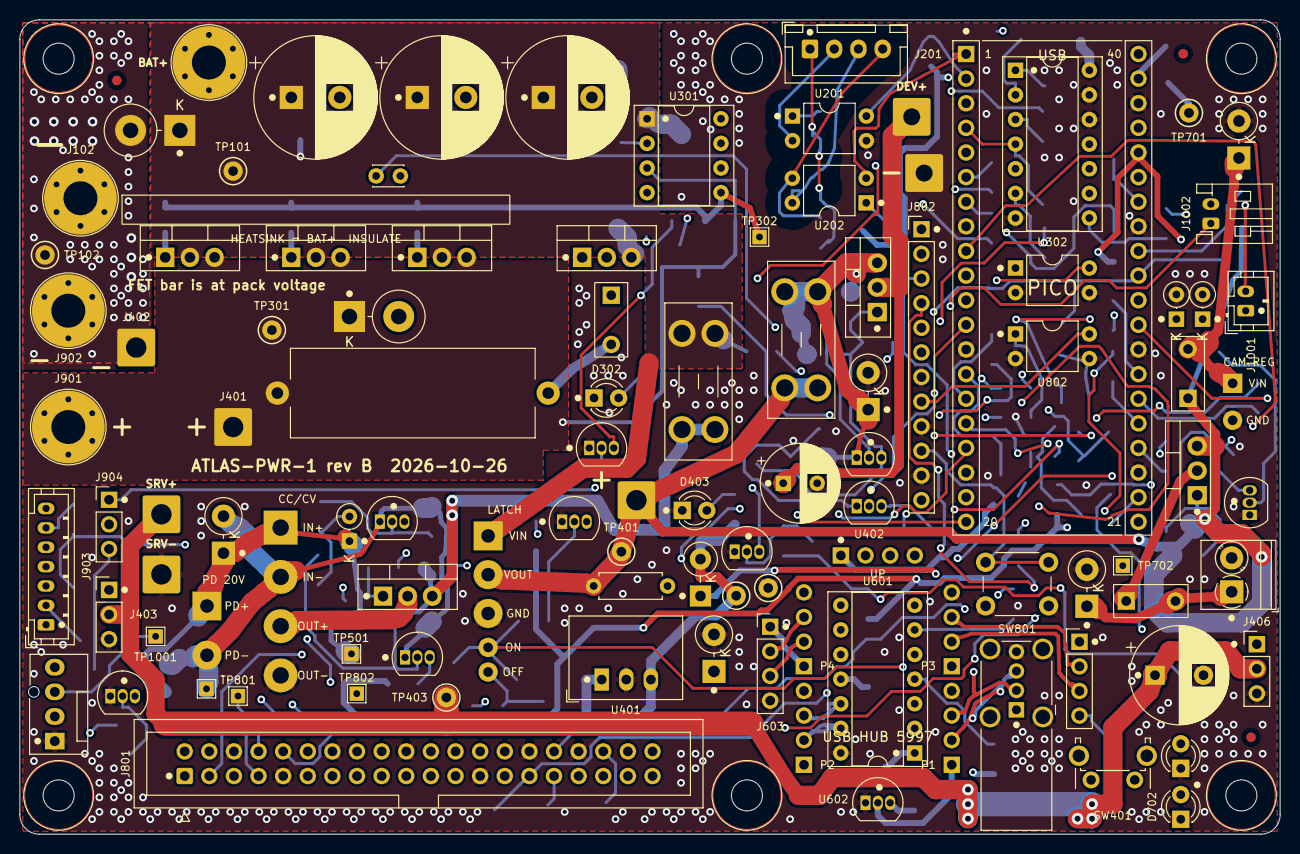
[picture p24: board atlas_power.kicad_pcb from above]

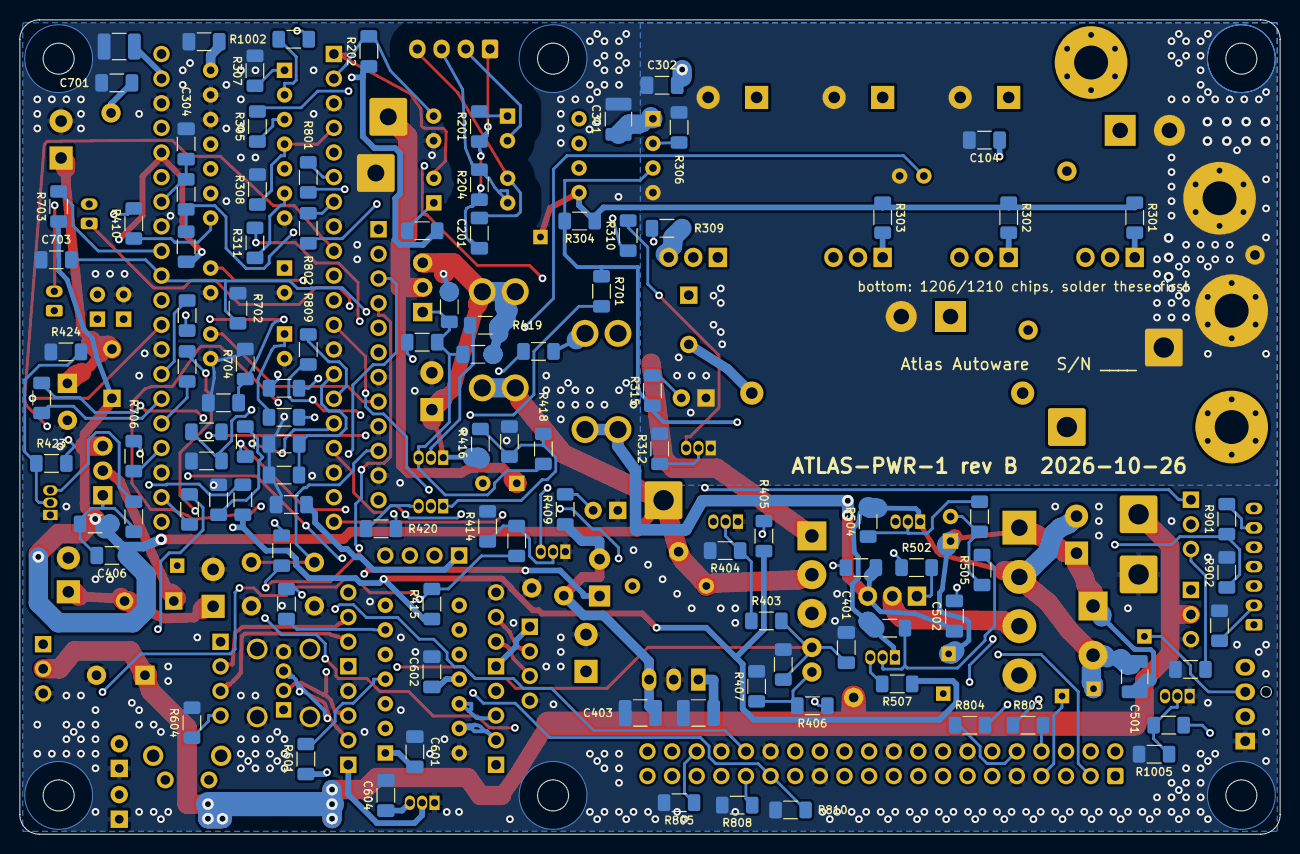
[picture p25: board atlas_power.kicad_pcb from below]

Board: 4 copper layers, 130.0 x 84.0 mm, 218 parts (107 on the bottom side), 133 nets.

Parts:
C101, C102, C103: 680u 35V; CP_Radial_D12.5mm_P5.00mm
C104: 1u 50V; C_1206_3216Metric_Pad1.33x1.80mm_HandSolder
C201, C302, C303, C304, C401, C406, C407, C502, C601, C602, C701, C703, C704: 100n; C_1206_3216Metric_Pad1.33x1.80mm_HandSolder
C301, C402, C403, C501, C702: 10u 50V; C_1210_3225Metric_Pad1.33x2.70mm_HandSolder
C404: 1000u 16V; CP_Radial_D10.0mm_P5.00mm
C405: 150u 35V; CP_Radial_D8.0mm_P3.50mm
C603, C604: 1u; C_1206_3216Metric_Pad1.33x1.80mm_HandSolder
C1001: 10n; C_1206_3216Metric_Pad1.33x1.80mm_HandSolder
D101: 1.5KE20A; D_DO-201AD_P5.08mm_Vertical_KathodeUp
D301: 1.5KE22A; D_DO-201AD_P5.08mm_Vertical_KathodeUp
D302, D702: RED; LED_D3.0mm
D401: P6KE20A; D_DO-15_P3.81mm_Vertical_KathodeUp
D402: 1N5817; D_DO-41_SOD81_P3.81mm_Vertical_KathodeUp
D403, D701: GREEN; LED_D3.0mm
D404, D405, D406: P6KE22A; D_DO-15_P3.81mm_Vertical_KathodeUp
D501: P6KE24A; D_DO-15_P3.81mm_Vertical_KathodeUp
D502: 1N5247B; D_DO-35_SOD27_P2.54mm_Vertical_KathodeUp
D1001, D1002: BAT85; D_DO-35_SOD27_P2.54mm_Vertical_KathodeUp
F301: MF-R050; Fuse_Bourns_MF-R_P5.08mm
F401, F501: 5A mini; Fuseholder_Blade_Mini_Keystone_3568
F402, F403: MF-R075; Fuse_Bourns_MF-R_P5.08mm
FID1, FID2, FID3: Fiducial; Fiducial_1mm_Mask2mm
H1001, H1002, H1003, H1004, H1005, H1006: M3; MountingHole_3.2mm_M3_Keepout7mm
HS301: HEATSINK_BAR; Heatsink_Bar_3xTO220_40x15x3mm
J101: BAT+; WirePad_THT_10AWG_D3.5mm_OD7.5mm
J102: BAT-; WirePad_THT_10AWG_D3.5mm_OD7.5mm
J201: BMS_UART; JST_XH_B4B-XH-A_1x04_P2.50mm_Vertical
J401: BEC+; SolderWire-1.5sqmm_1x01_D1.7mm_OD3.9mm
J402: BEC-; SolderWire-1.5sqmm_1x01_D1.7mm_OD3.9mm
J403: BEC_OUT; PinHeader_1x03_P2.54mm_Vertical
J404: SRV+; SolderWire-1.5sqmm_1x01_D1.7mm_OD3.9mm
J405: SRV-; SolderWire-1.5sqmm_1x01_D1.7mm_OD3.9mm
J406: SERVO; PinHeader_1x03_P2.54mm_Vertical
J407: DEV+; SolderWire-1sqmm_1x01_D1.4mm_OD3.9mm
J408: DEV-; SolderWire-1sqmm_1x01_D1.4mm_OD3.9mm
J409: LIDAR_PWR; TerminalBlock_Phoenix_PT-1,5-2-3.5-H_1x02_P3.50mm_Horizontal
J410: BEC+ALT; SolderWire-1.5sqmm_1x01_D1.7mm_OD3.9mm
J601: DEVKIT_USB; USB_A_Wuerth_614004134726_Horizontal
J602: VESC_USB; PinHeader_1x04_P2.54mm_Vertical
J603: HUB_PORT4; PinHeader_1x04_P2.54mm_Vertical
J801: J12_RIBBON; IDC-Header_2x20_P2.54mm_Vertical
J802: J14_HARNESS; PinHeader_1x12_P2.54mm_Vertical
J901: ESC+; WirePad_THT_10AWG_D3.5mm_OD7.5mm
J902: ESC-; WirePad_THT_10AWG_D3.5mm_OD7.5mm
J903: FSESC_COMM; JST_PH_B7B-PH-K_1x07_P2.00mm_Vertical
J904: SERVO_IN; PinHeader_1x03_P2.54mm_Vertical
J1001: ESTOP; JST_PH_B2B-PH-K_1x02_P2.00mm_Vertical
J1002: BTN_REMOTE; JST_PH_S2B-PH-K_1x02_P2.00mm_Horizontal
J1003: FAN; FanPinHeader_1x04_P2.54mm_Vertical
MOD401: POLOLU_2813; WireLand_Pololu_2813
MOD402: POLOLU_S18V20F12; WireLand_Pololu_S18V20F12
MOD501: ADA5807_HUSB238; WireLand_PD_Trigger
MOD502: CCCV_BUCK_XL4015; WireLand_CCCV_Buck
MOD601: ADA5997_CH334F_HUB; Adafruit_5997_CH334F_Hub_Headers
MOD701: RPi_Pico; RaspberryPi_Pico_Socketed_2x20_P17.78mm
Q301, Q302, Q303: IRFB7430PBF; TO-220-3_Vertical
Q304, Q405: IRF9Z34NPBF; TO-220-3_Vertical
Q305, Q401, Q403, Q406, Q502, Q503: 2N3904; TO-92_Inline
Q402, Q501: IRF4905PBF; TO-220-3_Vertical
Q404: 2N3906; TO-92_Inline
Q1001: 2N7000; TO-92_Inline
R201, R305, R406, R602, R804, R805, R812, R813, R901, R1001: 1k; R_1206_3216Metric_Pad1.30x1.75mm_HandSolder
R202, R204, R311, R315, R413, R420, R423: 4.7k; R_1206_3216Metric_Pad1.30x1.75mm_HandSolder
R203, R419, R705, R706, R814, R815: 470; R_1206_3216Metric_Pad1.30x1.75mm_HandSolder
R301, R302, R303: 10; R_1206_3216Metric_Pad1.30x1.75mm_HandSolder
R304: 2.2M; R_1206_3216Metric_Pad1.30x1.75mm_HandSolder
R306, R307, R308, R312, R404, R407, R414, R416, R424, R701, R703, R807, R808, R810, R902, R904, R1005: 100k; R_1206_3216Metric_Pad1.30x1.75mm_HandSolder
R309, R310, R314, R316, R402, R405, R411, R415, R421, R422, R501, R507, R601, R603, R803, R806, R809, R811, R903, R1003: 10k; R_1206_3216Metric_Pad1.30x1.75mm_HandSolder
R313: 10 5W; R_Axial_Power_L25.0mm_W9.0mm_P27.94mm
R401: 33k; R_1206_3216Metric_Pad1.30x1.75mm_HandSolder
R403: 22k; R_1206_3216Metric_Pad1.30x1.75mm_HandSolder
R408: 4.7; R_Axial_DIN0207_L6.3mm_D2.5mm_P7.62mm_Horizontal
R409: 2.2k; R_1206_3216Metric_Pad1.30x1.75mm_HandSolder
R410: 220; R_1206_3216Metric_Pad1.30x1.75mm_HandSolder
R412, R502: 6.8k; R_1206_3216Metric_Pad1.30x1.75mm_HandSolder
R417: 15.0k; R_1206_3216Metric_Pad1.30x1.75mm_HandSolder
R418: 1.2M; R_1206_3216Metric_Pad1.30x1.75mm_HandSolder
R503, R504, R505, R506: 47k; R_1206_3216Metric_Pad1.30x1.75mm_HandSolder
R604: 2.2; R_1206_3216Metric_Pad1.30x1.75mm_HandSolder
R702, R704: 18k; R_1206_3216Metric_Pad1.30x1.75mm_HandSolder
R801, R802: 330; R_1206_3216Metric_Pad1.30x1.75mm_HandSolder
R905, R906: 3.3; R_1206_3216Metric_Pad1.30x1.75mm_HandSolder
R1002, R1004: 100; R_1206_3216Metric_Pad1.30x1.75mm_HandSolder
SW401: POWER; SW_Tactile_SPST_Angled_PTS645Vx58-2LFS
SW801: RECOVERY; SW_PUSH_6mm_H5mm
TH301: 10k B3977; C_Disc_D3.0mm_W2.0mm_P2.50mm
TP101: BAT; TestPoint_Keystone_5000-5004_Miniature
TP102, TP1002: GND; TestPoint_Keystone_5000-5004_Miniature
TP301: VM; TestPoint_Keystone_5000-5004_Miniature
TP302: SW_GATE; TestPoint_THTPad_1.5x1.5mm_Drill0.7mm
TP401: VSYS_SW; TestPoint_Keystone_5000-5004_Miniature
TP402: +5V; TestPoint_Keystone_5000-5004_Miniature
TP403: SERVO_V; TestPoint_Keystone_5000-5004_Miniature
TP501: CHG_IN; TestPoint_THTPad_1.5x1.5mm_Drill0.7mm
TP502: CHG_GND; TestPoint_THTPad_1.5x1.5mm_Drill0.7mm
TP701: +3V3; TestPoint_Keystone_5000-5004_Miniature
TP702: PICO_RUN; TestPoint_THTPad_1.5x1.5mm_Drill0.7mm
TP801: J12_GPIO09; TestPoint_THTPad_1.5x1.5mm_Drill0.7mm
TP802: J12_GPIO12; TestPoint_THTPad_1.5x1.5mm_Drill0.7mm
TP1001: FAN_TACH; TestPoint_THTPad_1.5x1.5mm_Drill0.7mm
U201, U202, U801, U802: PC817; DIP-4_W7.62mm
U301: MIC5014; DIP-8_W7.62mm_Socket
U302: 74HCT08; DIP-14_W7.62mm_Socket
U401: R-78E5.0-1.0; Converter_DCDC_RECOM_R-78E-0.5_THT
U402: TL431; TO-92_Inline
U601: MCP2221A; DIP-14_W7.62mm_Socket
U602: MCP1700-3302E/TO; TO-92_Inline

Connections:
+3V3: C701.1, D1002.1, MOD701.36, R202.1, R203.1, R314.1, R405.1, R415.1, R507.1, R1001.1, TP701.1
+5V: C303.1, C403.1, D402.2, J1003.2, R409.1, TP402.1, U302.10, U302.14, U401.3
AND_MAIN: R305.1, U302.3
AND_PRE: R311.1, U302.6
BAT: C101.1, C102.1, C103.1, C104.1, C301.1, C302.1, D101.1, F501.2, J101.1, MOD401.1, Q301.2, Q302.2, Q303.2, Q304.3, R309.1, R401.1, TP101.1, U301.1
BAT_SENSE: C704.1, MOD701.32, R703.2, R704.1
BMS_GND: C201.2, J201.4, U202.3
BMS_OPT1_A: R201.2, U201.1
BMS_OPT2_A: R203.2, U202.1
BMS_RX: MOD701.2, R202.2, U201.4
BMS_RXD: J201.3, R204.2, U202.4
BMS_TX: MOD701.1, U202.2
BMS_TXD: J201.2, U201.2
BMS_VDD: C201.1, J201.1, R201.1, R204.1
BTN_B: Q401.2, R403.2, R404.1
BTN_HI: J1002.1, R401.2, SW401.1
BUTTON_N: MOD701.17, Q401.3, R405.2
CAM_VIN: D406.1, F403.2, MOD402.1
CHG_B1: Q502.2, R503.2, R504.1
CHG_B2: Q503.2, R505.2, R506.1
CHG_C: Q502.3, R502.2
CHG_G: C502.2, Q501.1, R501.2, R502.1
CHG_GND: C501.2, D501.2, MOD501.2, MOD502.2, Q502.1, Q503.1, R504.2, R506.2, TP502.1
CHG_IN: C501.1, D501.1, D502.1, MOD501.1, MOD502.1, TP501.1
CHG_OUT: MOD502.3, Q501.2
CHG_PRESENT_N: MOD701.20, Q503.3, R507.2
CHG_RB: C502.1, F501.1, Q501.3, R501.1
CHG_STAT_N_TO_JETSON: MOD701.26, R813.1
CHG_Z: D502.2, R503.1, R505.1
COMM_ADC2: J903.6, R901.2
COMM_GND: J903.2, R905.1
COMM_RX: J903.4, R803.2
COMM_TX: J903.3, R804.1
CON_3V3: C601.1, C602.1, C604.1, R601.1, U601.1, U601.11, U602.3
CON_RST: R601.2, U601.4
CON_RX: R603.2, U601.5
CON_TX: R602.1, U601.6
DEVKIT_PWR: MOD701.29, R413.1, R415.2
DEV_B: Q403.2, R413.2, R414.1
ESTOP_IN: D1001.1, D1002.2, J1001.2, R1002.1
ESTOP_OK: C1001.1, MOD701.14, R1002.2, R1003.1, U302.2, U302.5
ESTOP_OK_TO_JETSON: MOD701.25, R812.1
ESTOP_SRC: J1001.1, R1001.2
FAN_G: Q1001.2, R1004.2, R1005.1
FAN_PWM: MOD701.21, R1004.1
FAN_PWM_N: J1003.4, Q1001.3
FAN_TACH: J1003.3, TP1001.1
FET_NTC: C304.1, MOD701.34, R316.2
GND: C101.2, C102.2, C103.2, C104.2, C301.2, C302.2, C303.2, C304.2, C401.2, C402.2, C403.2, C404.2, C405.2, C601.2, C602.2, C603.2, C604.2, C701.2, C702.2, C703.2, C704.2, C1001.2, D101.2, D301.2, D302.1, D401.2, D403.1, D404.2, D405.2, D406.2, D701.1, D702.1, D1001.2, J102.1, J402.1, J403.3, J405.1, J406.3, J408.1, J409.2, J601.4, J601.5, J603.4, J801.6, J801.9, J801.14, J801.20, J801.25, J801.30, J801.34, J802.7, J802.9, J802.11, J902.1, J1003.1, MOD401.3, MOD402.2, MOD502.4, MOD601.4, MOD601.8, MOD601.12, MOD601.16, MOD601.20, MOD701.3, MOD701.8, MOD701.13, MOD701.18, MOD701.23, MOD701.28, MOD701.33, MOD701.38, Q305.1, Q401.1, Q403.1, Q406.1, Q1001.1, R306.2, R307.2, R308.2, R312.2, R402.2, R404.2, R407.2, R414.2, R417.2, R424.2, R604.2, R702.2, R704.2, R805.2, R807.2, R808.2, R810.2, R902.2, R904.2, R905.2, R906.2, R1003.2, R1005.2, SW801.2, TH301.2, TP102.1, TP1002.1, U201.3, U301.4, U302.7, U302.12, U302.13, U401.2, U402.2, U601.14, U602.1, U801.2, U801.3, U802.2, U802.3
HUB_VBUS: C603.1, J601.1, J602.1, J603.1, MOD601.1, MOD601.5, MOD601.9, MOD601.13, MOD601.17, U602.2
I2C0_SCL: MOD701.7, R802.2
I2C0_SDA: MOD701.6, R801.2
J12_3V3: J801.17, R806.1
J12_CHG_STAT_N: J801.32, R813.2
J12_CTS: J801.36, R805.1
J12_ESTOP_OK: J801.33, R812.2
J12_GPIO09: J801.7, TP801.1
J12_GPIO12: J801.15, TP802.1
J12_JETSON_UP: J801.31, R808.1, R809.1
J12_LIDAR_REQ: J801.29, R810.1, R811.1
J12_RXD: J801.10, R804.2
J12_SCL: J801.5, R802.1
J12_SDA: J801.3, R801.1
J12_TXD: J801.8, R803.1
J14_CON_RXD: J802.3, R602.2
J14_CON_TXD: J802.4, R603.1
J14_PWR_KEY_N: J802.12, U801.4
J14_RECOVERY_N: J802.10, SW801.1
J14_RESET_N: J802.8, U802.4
JETSON_3V3_SENSE: MOD701.16, R806.2, R807.1
JETSON_PWR_KEY: MOD701.10, R814.1
JETSON_RESET: MOD701.11, R815.1
JETSON_UP: MOD701.15, R809.2
LATCH_OFF: MOD701.12, R406.1
LATCH_OFF_M: MOD401.5, R406.2, R407.1
LATCH_ON: C401.1, J1002.2, MOD401.4, R402.1, R403.1, SW401.2
LED5_A: D403.2, R409.2
LEDF_A: D702.2, R706.2
LEDS_A: D701.2, R705.2
LED_FAULT: MOD701.24, R706.1
LED_STATUS: MOD701.22, R705.1
LIDAR_EN: MOD701.9, R423.1
LIDAR_REQ: MOD701.27, R811.2
LIDAR_V: D405.1, F402.2, J409.1
LID_B: Q406.2, R423.2, R424.1
LID_C: Q406.3, R422.2
LID_G: C406.2, Q405.1, R421.2, R422.1
LID_SW: F402.1, Q405.2
MAIN_EN: MOD701.5, R307.1, U302.1
MIC_IN: R305.2, R306.1, U301.2
NTC_NODE: R314.2, R316.1, TH301.1
OV_B: Q404.2, R419.2, R420.1
OV_C: Q403.3, R412.2
OV_G: C407.2, Q402.1, Q404.3, R411.2, R412.1, R418.1
OV_K: R420.2, U402.3
OV_REF: R416.2, R417.1, R418.2, U402.1
P1_DM: J601.2, MOD601.7
P1_DP: J601.3, MOD601.6
P2_DM: MOD601.11, U601.12
P2_DP: MOD601.10, U601.13
P3_DM: J602.2, MOD601.15
P3_DP: J602.3, MOD601.14
P4_DM: J603.2, MOD601.19
P4_DP: J603.3, MOD601.18
PICO_RUN: MOD701.30, TP702.1
PICO_VSYS: C702.1, D402.1, MOD701.39
PRECHARGE_EN: MOD701.4, R308.1, U302.4
PRE_B: Q305.2, R311.2, R312.1
PRE_C: Q305.3, R310.2
PRE_D: F301.1, Q304.2
PRE_F: F301.2, R313.1
PRE_G: Q304.1, R309.2, R310.1
PWRKEY_A: R814.2, U801.1
RESET_A: R815.2, U802.1
SERVO_BUF: R410.1, U302.8
SERVO_IN: R903.2, R904.1, U302.9
SERVO_IN_J: J904.1, R903.1
SERVO_SIG: J406.1, R410.2
SERVO_V: C404.1, J403.2, J404.1, J406.2, TP403.1
SRVIN_GND: J904.3, R906.1
SW_G1: Q301.1, R301.2
SW_G2: Q302.1, R302.2
SW_G3: Q303.1, R303.2
SW_GATE: R301.1, R302.1, R303.1, R304.1, TP302.1, U301.5
V5_IN: C402.1, D401.1, R408.2, U401.1
VDEV: C405.1, J407.1, Q402.2
VDEV_F: C407.1, D404.1, F401.2, Q402.3, Q404.1, R411.1, R416.1, R419.1
VESC_KILL: MOD701.19, R901.1, R902.1
VM: D301.1, J401.1, J901.1, Q301.3, Q302.3, Q303.3, R304.2, R313.2, R315.1, R701.1, TP301.1, U301.3
VM_LED_A: D302.2, R315.2
VM_SENSE: C703.1, MOD701.31, R701.2, R702.1
VSYS_SW: C406.1, F401.1, F403.1, J410.1, MOD401.2, Q405.3, R408.1, R421.1, R703.1, TP401.1
VUSB_GND: J602.4, R604.1
