AtlasAutoware/car1v2/(commit log)

2026-11-09 Power board: mark R801, R802, R805 do-not-populate on the PCB to match the schematic
    KiCad 10.0.8 DRC with schematic parity reported three footprint/symbol mismatches,
    all the same kind: the schematic marks these three 1206 resistors DNP and the board
    footprints did not carry the flag. Copper, pads and Gerbers are unchanged.
    Claude-Session: https://claude.ai/code/session_01AvZsupyMHm2YJfJc9FNcCs
    [atlas_power.kicad_pcb]
2026-11-09 Car 1 v2: design, priced carts, firmware profile, mounts, aero study, student guides
    Car 1 v2 is the rebuild of car 1 on the rev B design, cut down to what the club owns:
    Slash 4x4 chassis, Puller Pro motor, INJS235 servo, the spare FSESC, the second Jetson
    dev kit, an owned 4S LiPo, and car 1's RPLidar C1 and OAK-D Pro (no software change).
    - docs/CAR1V2.md: what the car is made of and why, what a sensor change costs in software,
    how the three must-haves are met, settings, and what is not verified
    - docs/CAR1V2_BUILD.md, CAR1V2_CHECKLIST.md, CAR1V2_WIRING.md: student build and bring-up
    guide, the hands-on checklist, and the wiring diagram
    - bom/car1v2/: make_car1v2.py computes every ca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
    [bms_fence_jk.3mf, bms_fence_jk.step, bms_fence_jk.stl, body.stl, c1_plinth.3mf, c1_plinth.step, c1_plinth.stl, c1_plinth_plan.dxf]
2026-11-09 Car 1 v2: independent review, its first fixes, and the speed study
    Review (docs/review_car1v2_2026-11-09.md): schematic, BOM math and budget each "pass with
    fixes". Fixed here:
    - S1: R419 10k -> 470 ohm. A TL431 below its threshold can still draw enough current to turn
    Q404 on through 10k and hold the Jetson's feed off. Value change only, same 1206 pads; the
    schematic, board value text, parts list, BOMs and fab lists are updated together
    - B1, B2: the two "L" capacitors in the DigiKey cart are the wrong cans. Replaced with parts
    read on their DigiKey pages today (EEU-FM1V681, EEU-FM1C102, CL32B106KBJNNNE, and
    EEU-FM1V151 for C405, which is a value change from 220 to 150 uF)
    - B3, B4,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
    [atlas_power.kicad_pcb, atlas_power_bom.csv, atlas_power_bom_bottom_smd.csv, atlas_power_d_rails.kicad_sch, cart_digikey.csv, cart_other.csv, comp_track_raceline.csv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]
2026-11-09 Car 1 v2: the rest of the review fixes, part numbers that are in stock, more tests
    - Capacitor part numbers changed to parts in stock at DigiKey on 2026-11-09, in the design
    source, schematic, board fields, parts list, BOMs and fab lists together: EEU-FM1V681
    (C101 to C103), EEU-FM1C102 (C404), EEU-FM1V151 (C405, 150 uF instead of 220 uF),
    CL32B106KBJNNNE (10 uF), C1206C105K5RACTU (1 uF), TL431ACLP (U402, straight leads).
    No copper change; the Gerbers are the ones from Oct 26
    - docs/CAR1V2.md: what the review found about the E-stop, fuses and battery levels, said
    plainly; BMS under-voltage back to 3.00 V; regen, ERPM and pinion settings
    - Checklist: LiHV check, breadboard test of t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
    [atlas_power.kicad_pcb, atlas_power_a_pack.kicad_sch, atlas_power_bom.csv, atlas_power_bom_bottom_smd.csv, atlas_power_c_switch.kicad_sch, atlas_power_d_rails.kicad_sch, atlas_power_e_charge.kicad_sch, atlas_power_f_debug.kicad_sch]
2026-11-09 Power board: KiCad 10 ERC and DRC re-run after the value changes (0 errors, 0 parity issues)
2026-11-09 Car 1 v2 budget: DigiKey cart as it stands (83 lines), PCBWay and JLCPCB board prices read today
    [cart_digikey.csv, cart_other.csv]
2026-11-09 Car 1 v2: named 3D assembly (STEP, zipped), a picture of it, and a quick start for the builders
2026-11-09 Car 1 v2: the unverified list and the budget's price classes match what was read on 9 November
    [cart_other.csv]
2026-11-11 Car 1 v2: whole-car renders, power board renders, and the repository's new name
    The repository is renamed from carv2 to car1v2 on 11 November 2026: there is
    one car, and this is car 1 rebuilt. README, the flashing guide and the quick
    start use the new name.
    share/car1v2_scene.py builds the car 1 v2 scene (stage 1) from the same models
    as mech/car1v2_assembly.py, and render_car.py takes --scene and --prefix.
    Five renders at 1800 x 1200 are in share/car1v2_*.png. KiCad 10 renders of the
    populated power board are in boards/power/out/render/.
